sean-galloway/jetson-marker-turret/turret-gimbal/datasheets/INDEX.md

# Gimbal — Datasheets Index

Reference files for confirmed parts. Naming: `BOM#_part_part-number`. Maps to Section A of `Gimbal_BOM.xlsx`.

| BOM # | Part | Part number | File | Status |
|---|---|---|---|---|
| 1 | Closed-loop driver (×2, ships in the motor kit) | STEPPERONLINE **CL57T V4.1** | `01_driver_CL57T-V4.1_manual.pdf` | Confirmed · both units checked V4.1 |
| 2 | Planetary gearbox 5:1 | Ratio 5:1 Nema 23, Ø8 bore | `02_gearbox_5to1_Nema23_phi8mm.jpeg` | Confirmed |
| 3 | Turntable bearing | 8" lazy susan, 265 lb (VXB) | `03_turntable-bearing_8in-lazy-susan-265lb.png` | Bought · **needs measurement** |
| 4 | Tilt bearing | McMaster **5968K71** | `04_tilt-bearing_McMaster_5968K71.png` | Confirmed · need flange dims |
| 5 | Mounting hub (×2) | Ruland **FHT-MCL-14-SS** | `05_mounting-hub_Ruland_FHT-MCL-14-SS.pdf` | Confirmed · pattern known (Ø22, 2× M4) |
| 6 | Shoulder screw | McMaster **90298A716** | `06_shoulder-screw_McMaster_90298A716.png` | Confirmed |
| 10 | Power supply | DROK 48 V / 10 A / 480 W | `10_power-supply_DROK_48V-10A-480W.png` | Confirmed |
| 12 | Dowel pins | McMaster **91595A161** | `12_dowel-pins_McMaster_91595A161.png` | Confirmed |

## Still needed (not yet on file)
- **#1 Motor** (23HS45-4204D-E1000) — no motor datasheet here yet (StepperOnline/Amazon); the driver manual is on file.
- **#4 bearing flange dims** — the file is the catalog table; the exact 2-bolt flange spacing + hole Ø come from the McMaster product drawing (or match-drill plate 05).
- **#3 lazy susan pattern** — needs physical measurement (4 holes: PCD + hole Ø, both faces) once it arrives → makes plates 02/03.
- **Tripod head** — needs a straight-down photo → makes plate 06.

## Not a datasheet
- `IMG_5335.jpeg` (left in uploads) — photo of received screens + calibration checkerboard, not a part spec.
