sean-galloway/jetson-marker-turret/turret-gimbal/datasheets/02_gearbox_5to1_Nema23_phi8mm.jpeg

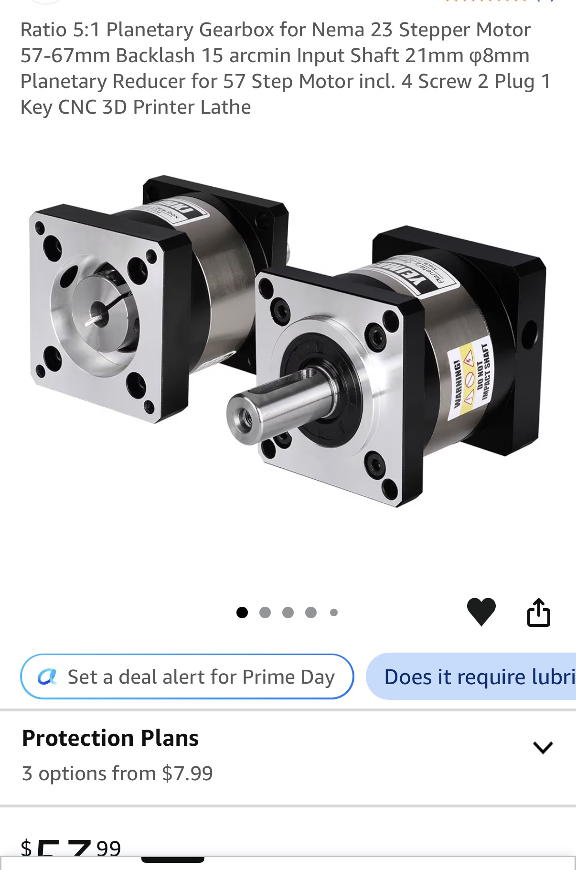
turret-gimbal/datasheets/02_gearbox_5to1_Nema23_phi8mm.jpeg
