sean-galloway/jetson-marker-turret/turret-gimbal/datasheets/03_turntable-bearing_8in-lazy-susan-265lb.png

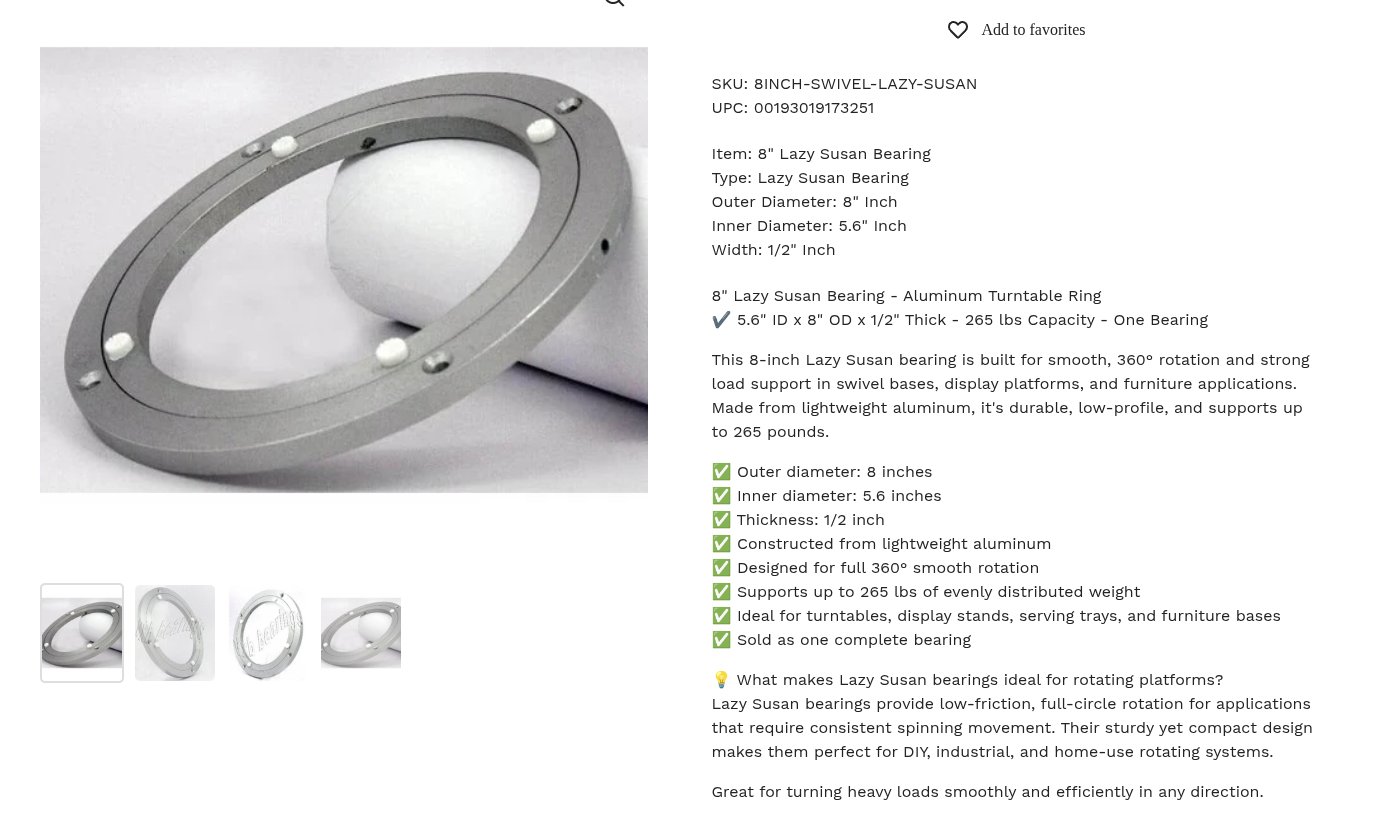
turret-gimbal/datasheets/03_turntable-bearing_8in-lazy-susan-265lb.png
