sean-galloway/jetson-marker-turret/turret-gimbal/datasheets/04_tilt-bearing_McMaster_5968K71.png

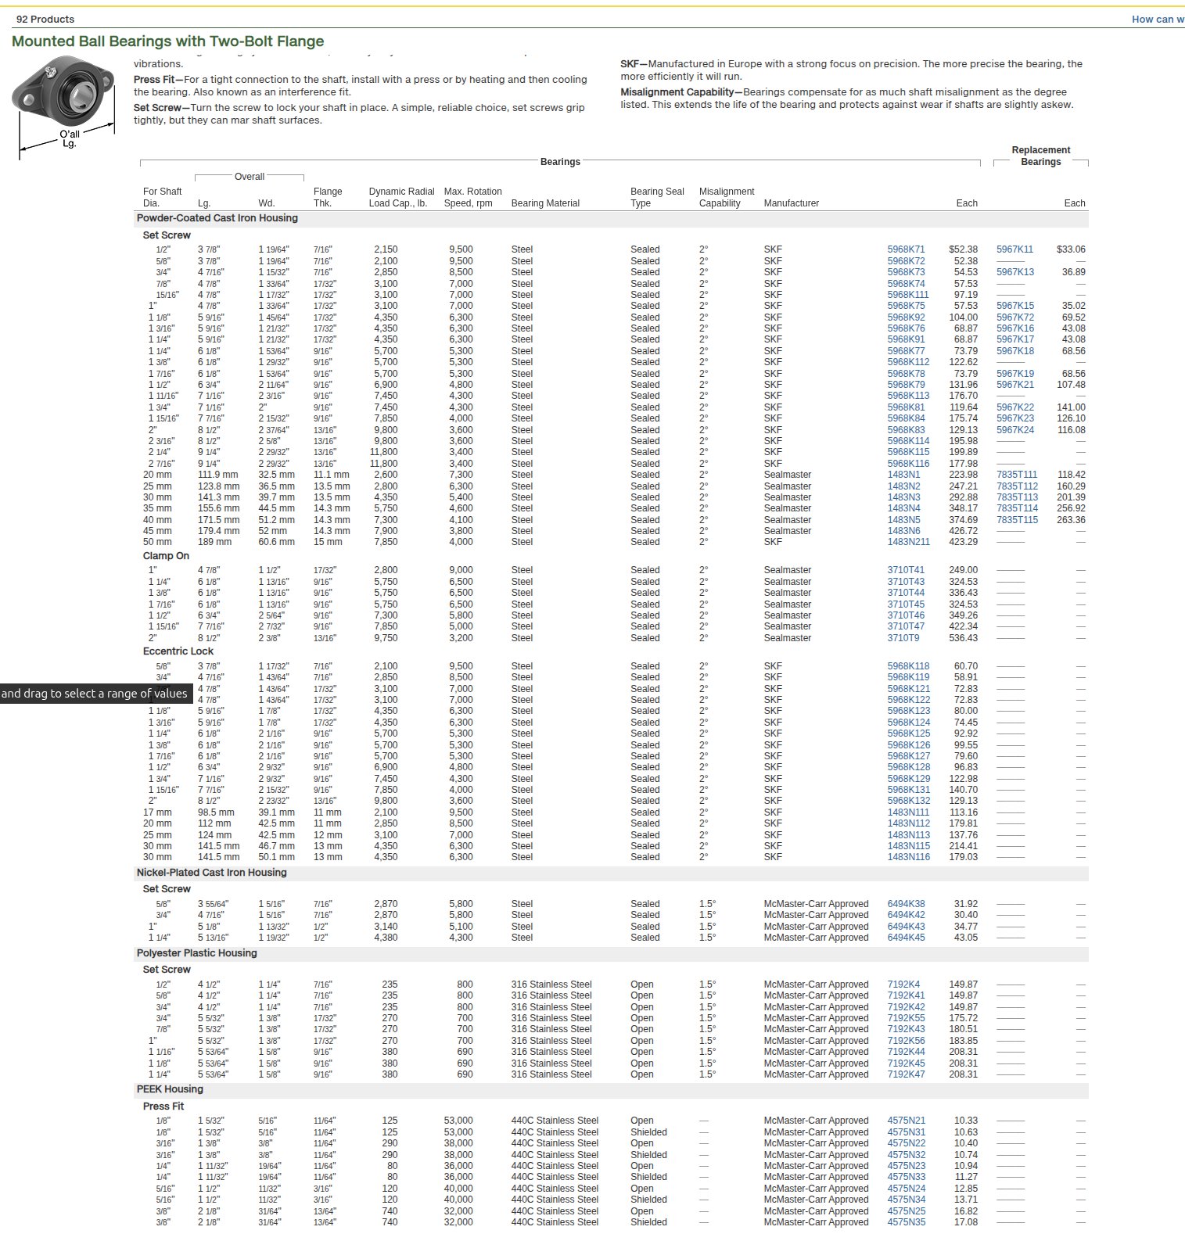
turret-gimbal/datasheets/04_tilt-bearing_McMaster_5968K71.png
