sean-galloway/jetson-marker-turret/turret-gimbal/datasheets/06_shoulder-screw_McMaster_90298A716.png

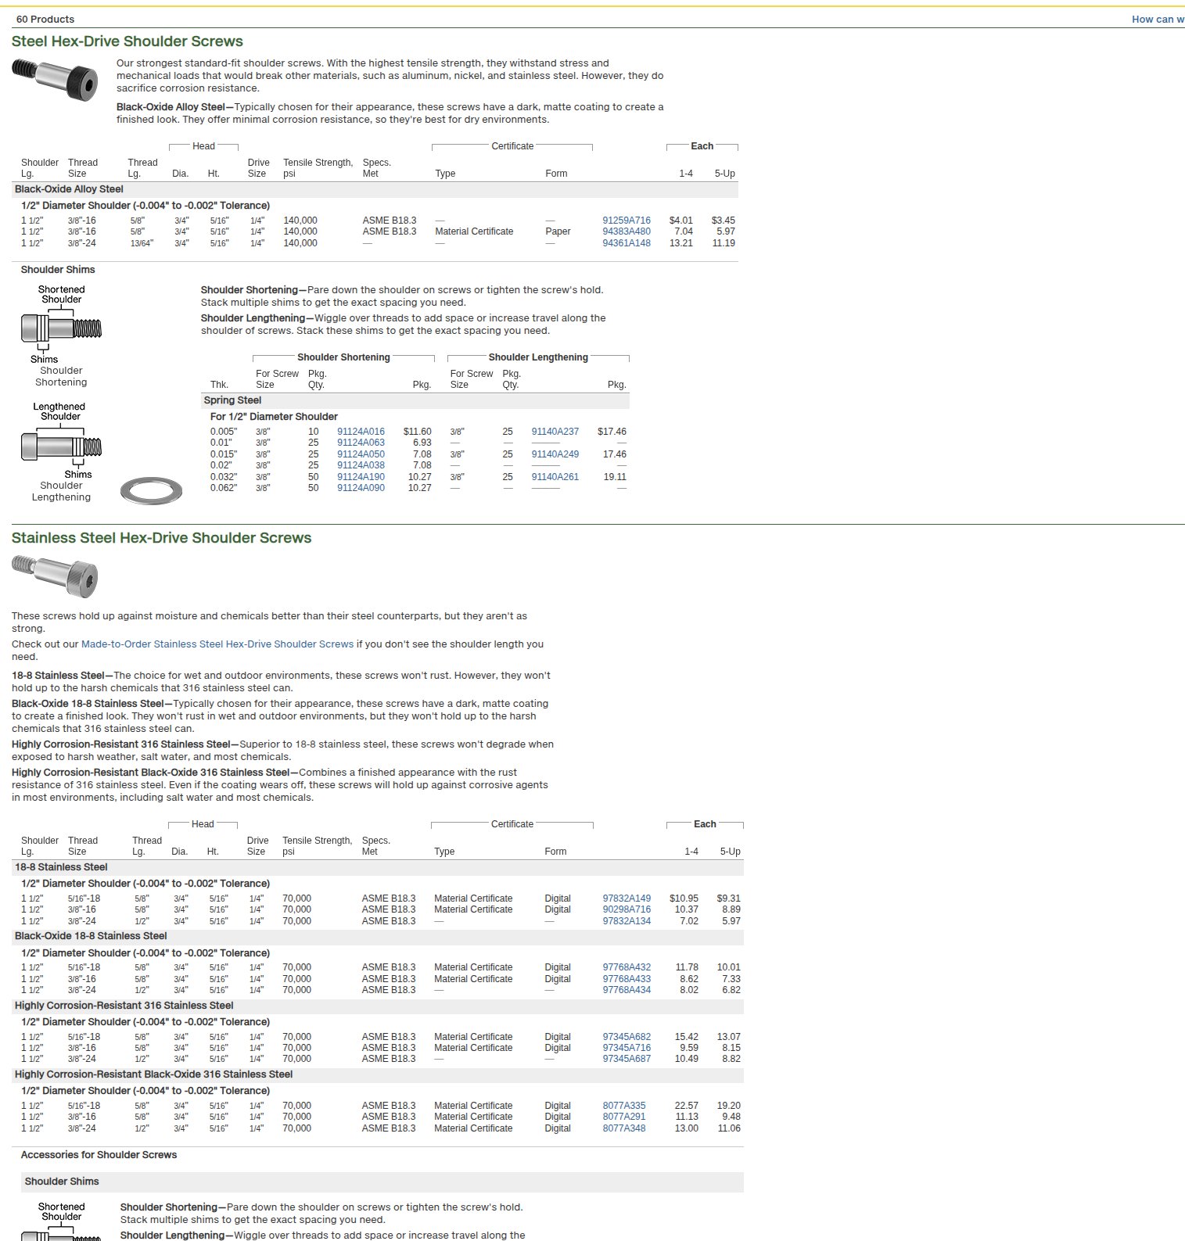
turret-gimbal/datasheets/06_shoulder-screw_McMaster_90298A716.png
