sean-galloway/jetson-marker-turret/turret-gimbal/datasheets/10_power-supply_DROK_48V-10A-480W.png

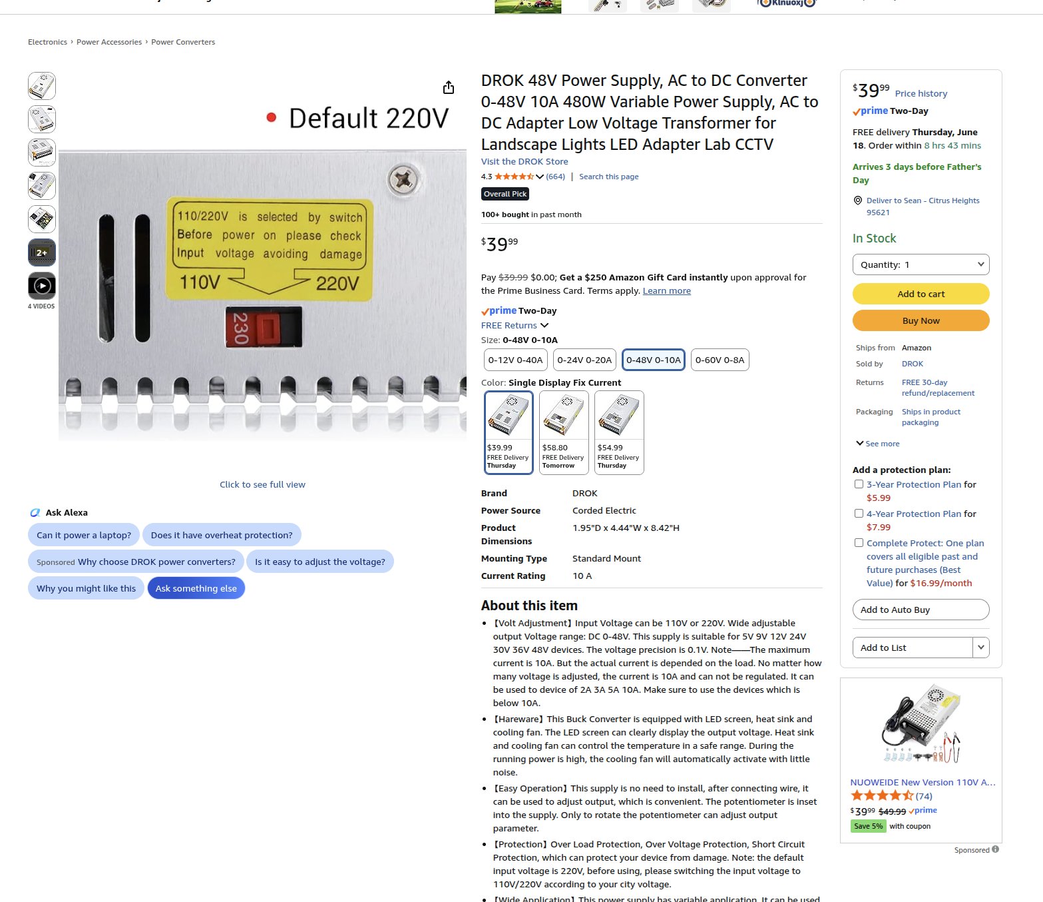
turret-gimbal/datasheets/10_power-supply_DROK_48V-10A-480W.png
