sean-galloway/jetson-marker-turret/turret-gimbal/datasheets/12_dowel-pins_McMaster_91595A161.png

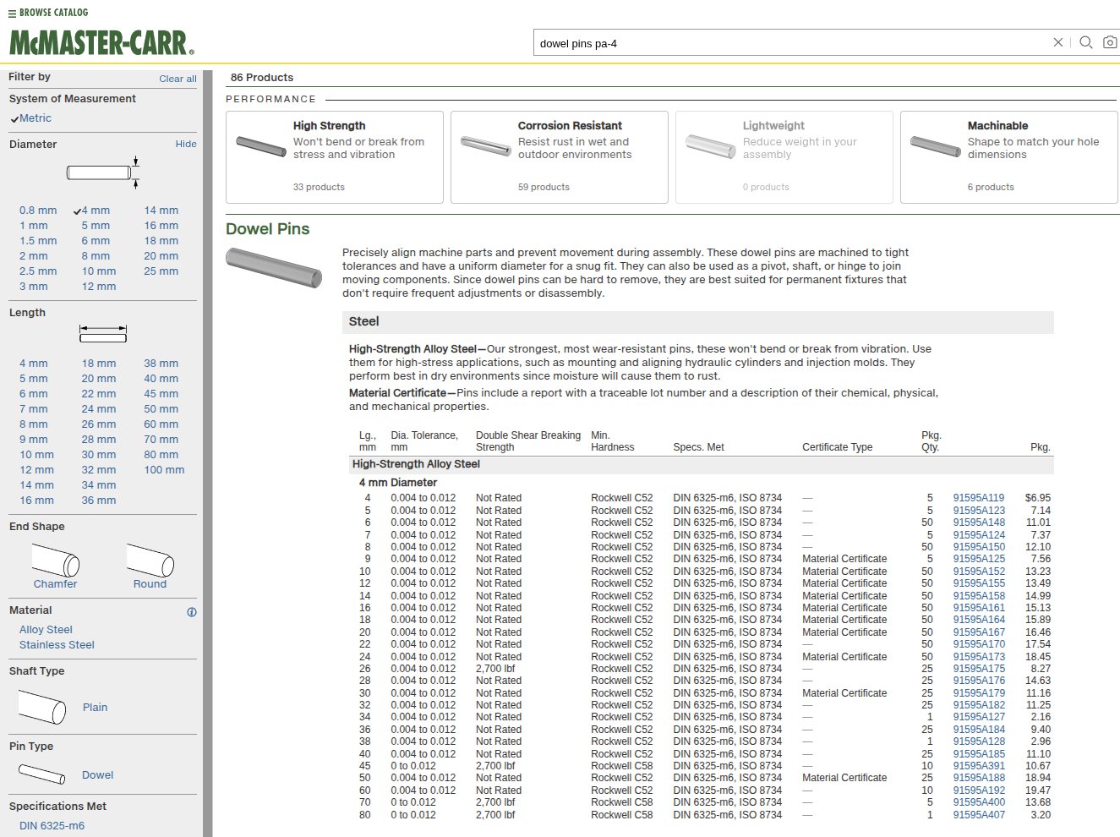
turret-gimbal/datasheets/12_dowel-pins_McMaster_91595A161.png
