sean-galloway/jetson-marker-turret/turret-gimbal/docs/assets/drawings/d1_exploded_full.png

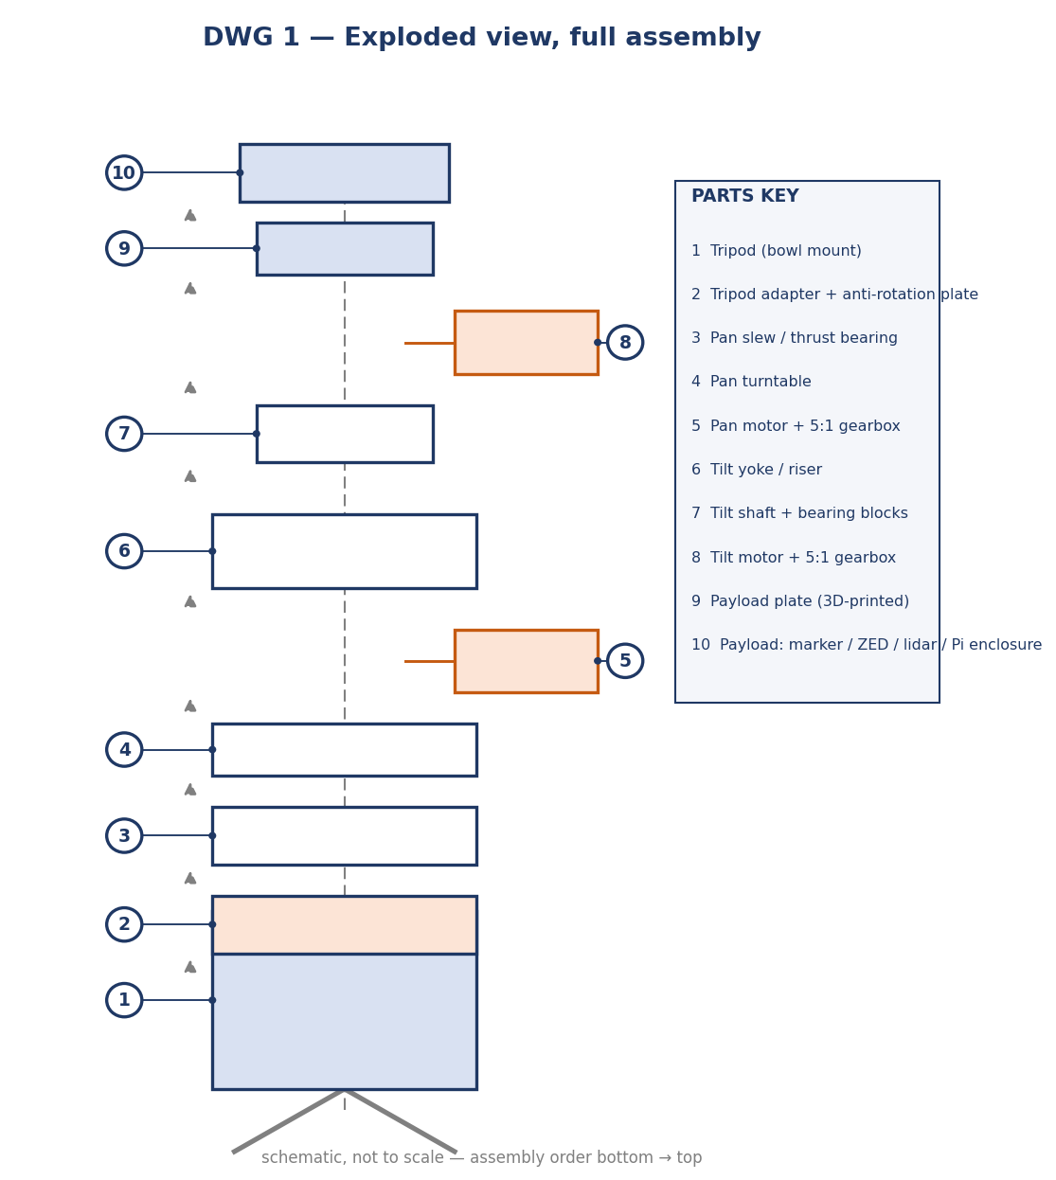
turret-gimbal/docs/assets/drawings/d1_exploded_full.png
