sean-galloway/jetson-marker-turret/turret-gimbal/docs/assets/proimg/pa4_payload_plate.png

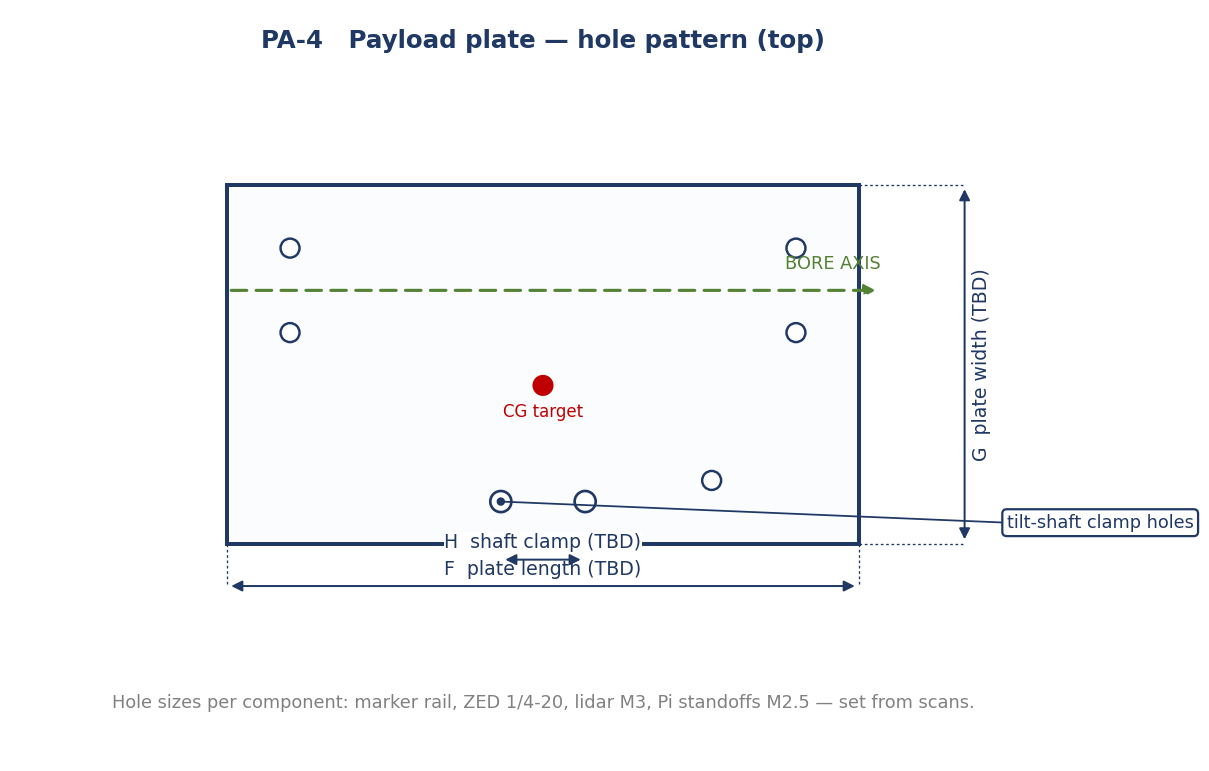
turret-gimbal/docs/assets/proimg/pa4_payload_plate.png
