sean-galloway/jetson-marker-turret/Turret_BOM_checklist.md

# Paintball Turret — Purchase Checklist

> Sections A–D: the turret system (payload on the gun · compute on the tripod · displays · power/wiring). Sections E–G: the bolt-together gimbal — BUY catalog · CUT (DXF, SendCutSend) · HAVE. Owned items are priced $0 so they stay out of the totals.

Two clickable boxes per item — **Ordered** and **Received** (works in GitHub, VS Code, Obsidian). Owned items are pre-ticked on both.

## A.  PAYLOAD — ON THE TURRET

- **#1 Paintball marker** — Bore-sighted reference for the ZED · owned
  
  - [x] Ordered
  
  - [x] Received
  
  - _Owned. Bore aligns to the pan axis; hopper top-rear._

- **#2 Push-pull solenoid (trigger)** — 12 V, 1 A, 20 N, 10 mm stroke · $13.99 · TOMMSILE 0837B-12V (Amazon)
  
  - [x] Ordered
  
  - [x] Received
  
  - _Trigger actuator; 12 V switched. 20 N is end-of-stroke; confirm trigger force after marker scan. Wire to a HAT high-current channel (CH1-4); onboard TVS handles flyback._

- **#3 Arming switch (SPST, LED, safety cover)** — SPST maintained, 20 A @ 12 V DC, illuminated, flip-up cover, 12 mm hole; in the 12 V solenoid+ line · $9.66 · Twidec ASW-07DRGYMZ (3-pack, Amazon) · 3rd pin = LED→GND (RED when armed); real interlock, not the panel's soft ARM
  
  - [x] Ordered
  
  - [x] Received
  
  - _HARDWARE INTERLOCK: open = cannot fire. Safety-critical._

- **#4 Laser sight (boresight aid)** — Mounts on top of the barrel · $15 · generic
  
  - [x] Ordered
  
  - [x] Received
  
  - _Zero to impact point at a set range, like a rifle._

- **#5 ZED 2i stereo camera** — 4 mm, polarizer; USB 3.0 · Stereolabs ZED 2i 4mm
  
  - [x] Ordered
  
  - [ ] Received
  
  - _Owned (~$549). Boresighted below the barrel; routes to the Jetson._

- **#6 ZED USB3 locking cable (3 m)** — USB 3.0 Type-C locking · Stereolabs
  
  - [x] Ordered
  
  - [ ] Received
  
  - _Owned._

- **#7 10-DOF IMU (BNO055 + BMP280)** — I2C Gravity plug (no solder); run IMU mode (no mag) · $25.90 · DFRobot Gravity SEN0253 · [link](https://www.dfrobot.com/product-1793.html)
  
  - [x] Ordered
  
  - [x] Received
  
  - _Leveling + stabilization; rigid to platform. Use IMU (no-mag) mode near steppers. Local I2C to the on-turret Pico (short run; no extender)._

- **#8 Benewake TF03 lidar (100 m)** — Single-point rangefinder; UART/CAN; IP67 · $220 · TF03-100
  
  - [x] Ordered
  
  - [x] Received
  
  - _Boresighted to the muzzle; range along the line of fire._

- **#9 Armed/Safe LED indicator (RED + GREEN)** — 12 mm metal, 12 V, IP67, pre-wired w/ internal resistor; on the turret · $27.18 · FILN 12mm IP67 (1 red + 1 green 2-pk) · RED on armed rail; GREEN via 12 V SPDT relay (XOR) or as power/ready light
  
  - [ ] Ordered
  
  - [ ] Received
  
  - _RED ARMED off the armed rail (hardware-true); GREEN SAFE. On the turret._

## B.  COMPUTE & CONTROL — ON THE TRIPOD

- **#10 NVIDIA Jetson AGX Orin 32 GB** — Vision/targeting module · AGX Orin 32GB
  
  - [x] Ordered
  
  - [x] Received
  
  - _Owned. Perception/targeting._

- **#11 Raspberry Pi 5 (8 GB)** — Supervisor · $80 · SC1112
  
  - [x] Ordered
  
  - [x] Received
  
  - _Setpoints, IMU/lidar, arming, state._

- **#12 Pi 5 Active Cooler** — — · $5 · SC1148
  
  - [x] Ordered
  
  - [x] Received
  
  - _Pi 5 throttles without it._

- **#13 Pi 27 W USB-C PD supply** — 5.1 V / 5 A · $12 · SC1158
  
  - [x] Ordered
  
  - [x] Received
  
  - _Powers the Pi + HAT reliably._

- **#14 microSD 64 GB A2** — — · $10 · SanDisk SDSQXAV-064G
  
  - [x] Ordered
  
  - [x] Received
  
  - _Pi OS / boot._

- **#15 Solenoid driver HAT (8-MOSFET)** — I2C; solid-state · $45 · Sequent Eight-MOSFETS
  
  - [x] Ordered
  
  - [x] Received
  
  - _Trigger drive; the only HAT on the stack now. Solenoid on a high-current channel (CH1-4): 12A@24V, onboard TVS clamps flyback — no external diode (CH5-8 are 240V/flyback-diode). CH5 = 48 V motor-rail enable: in series with the E-stop NC in the #64 coil return (see Drive_and_Cabling.md)._

- **#16 GPIO stacking header, 2×20 tall** — — · $3 · Adafruit 2223
  
  - [x] Ordered
  
  - [x] Received
  
  - _Passes GPIO up past the HAT._

- **#17 Top-of-stack GPIO breakout / proto-HAT** — — · $8 · Adafruit 2310
  
  - [x] Ordered
  
  - [x] Received
  
  - _Expose SPI (IMU), UART (lidar + the Pico link, via the #70 RS-485 transceiver), spare GPIO._

- **#18 Brass standoff / spacer kit (M2.5)** — — · $8 · generic
  
  - [x] Ordered
  
  - [x] Received
  
  - _Mount/space the HAT + Pi._

- **#19 Limit / homing switches** — 3D-printer mechanical endstop (lever microswitch on PCB, 1 m cable + plug, trigger LED, NO); GPIO to Pico · $10.99 · R REIFENG endstop (6-pack; 2 used + 4 spare)
  
  - [x] Ordered
  
  - [ ] Received
  
  - _One per axis → power-up homing → absolute aiming._

- **#20 Pico RP2040** — Motion coprocessor (step/dir) · $5 · Raspberry Pi Pico
  
  - [x] Ordered
  
  - [x] Received
  
  - _Drives both CL57T. ON THE TURRET with the drivers; reads IMU/limits/LED locally._

- **#21 Pico debug OLED (SSD1306)** — 128×64; I2C · $9 · Adafruit 938
  
  - [x] Ordered
  
  - [x] Received
  
  - _Pico debug: current routine/state, step/dir, homing, heartbeat, faults._

- **#70 RS-485 transceiver modules** — 3.3 V TTL↔RS-485, automatic direction control (MAX13487-class), onboard 120 Ω termination · $9.99 · generic 5-pack
  
  - [ ] Ordered
  
  - [ ] Received
  
  - _Pi 5↔Pico link over the umbilical: one at the Pi 5 UART (rack), one at the Pico UART (turret); half-duplex A/B on one twisted pair. Leave the 120 Ω fitted at both ends only. Price est._

- **#71 Raspberry Pi Zero 2 W (maintenance node)** — Wi-Fi 2.4 GHz; USB OTG set to host · owned · SC0510
  
  - [x] Ordered
  
  - [x] Received
  
  - _Owned (hostname turret-zero). OPTIONAL, on the turret beside the Pico: flash the Pico (mpremote) and tail its logs over Wi-Fi. NEVER in the command or heartbeat path._

- **#72 Turret 5 V buck (logic rail)** — 9–60 V in → 5 V, 3 A out · $11.99 · generic
  
  - [ ] Ordered
  
  - [ ] Received
  
  - _Turret logic: Pico + ELRS RX + IMU + OLED + Zero (~1.2 A peak). Feed point (switched vs unswitched 48 V) is open — see Drive_and_Cabling.md. Price est._

- **#73 Step/dir output buffer** — 74LVC07A hex open-drain buffer, 3.3 V in, 5 V-tolerant outputs, 24 mA sink; SOIC-14 + SOIC-14→DIP adapter · $9.79 · TI SN74LVC07AD ×3 (~$0.60 ea) + adapter pack ($7.99)
  
  - [ ] Ordered
  
  - [ ] Received
  
  - _Pico 3.3 V GPIO → CL57T opto inputs (need 3.5–5 V, 7–16 mA). One chip = all 6 channels (PUL/DIR/ENA ×2); 2 spares. Plus 6× 10 kΩ pull-downs + 0.1 µF decoupling (stock). Wiring: Drive_and_Cabling.md. Price est._

## C.  DISPLAYS & CALIBRATION

- **#22 1U rack display — Pi 5 (GeeekPi 6.91")** — 1424×280 touch, 1U rack mount · $89.99 · GeeekPi 6.91" 1U
  
  - [x] Ordered
  
  - [x] Received
  
  - _Pi 5 status/console bar. Bought; price est._

- **#23 1U rack display — Jetson (GeeekPi 6.91")** — 1424×280 touch, 1U rack mount · $89.99 · GeeekPi 6.91" 1U
  
  - [x] Ordered
  
  - [x] Received
  
  - _Jetson perception/status bar. Bought; price est._

- **#24 Checkerboard calibration target** — Rigid flat backing · owned
  
  - [x] Ordered
  
  - [x] Received
  
  - _Owned. Camera + boresight calibration._

- **#25 micro-HDMI → HDMI cable** — — · $7 · generic
  
  - [x] Ordered
  
  - [x] Received
  
  - _Pi 5 micro-HDMI → 6.91" display._

- **#26 DisplayPort → HDMI adapter** — — · $9 · generic
  
  - [x] Ordered
  
  - [x] Received
  
  - _AGX Orin DP → 6.91" display; verify._

## D.  POWER & WIRING

- **#27 12 V solenoid supply (adjustable)** — 3–24 V, 3 A, 72 W; set & lock at 12 V · $17.99 · Wefomey adjustable (Amazon)
  
  - [x] Ordered
  
  - [ ] Received
  
  - _Solenoid rail. Set 12 V on the display + lock the knob; center-positive tip. Motors use 48 V (#41)._

- **#28 Circuit protection — fuses + 48 V DC breaker** — ATC inline holders + fuse kit (12 V/logic) + DIHOOL 15 A DC breaker (48 V) · $26 · SIM&NAT (B0CN6TVHKH) + DIHOOL (B0CFCLPGNY) · fuses https://www.amazon.com/SIM-NAT-Automotive-Standard-Replacement/dp/B0CN6TVHKH · breaker https://www.amazon.com/DIHOOL-Disconnect-Breaker-Circuit-Outdoor/dp/B0CFCLPGNY
  
  - [ ] Ordered
  
  - [ ] Received
  
  - _Fuse the 24–48 V and 12 V rails; tie ALL grounds together._

- **#29 Ethernet cable, Cat6 (short)** — — · $6 · generic
  
  - [x] Ordered
  
  - [x] Received
  
  - _Pi↔Jetson via the rack switch (#55); short rack-internal patch — not on the umbilical._

- **#30 Jumper wires (DuPont M-F, M-M)** — — · $7 · generic
  
  - [ ] Ordered
  
  - [ ] Received
  
  - _Signals: IMU, lidar, Pico, switches._

- **#31 Hookup wire, 18–20 AWG** — — · $10 · generic
  
  - [ ] Ordered
  
  - [ ] Received
  
  - _Motor, solenoid, power runs._

- **#32 Wire ferrules / crimp terminals** — — · $9 · generic
  
  - [ ] Ordered
  
  - [ ] Received
  
  - _Driver/terminal terminations._

## E.  BUY — CATALOG PARTS

- **#33 Motor + driver kit** — NEMA 23 closed-loop 3.0 N·m + CL57T V4.1 · $171.98 · 23HS45-4204D-E1000 / Amazon B0C6943QBM
  
  - [x] Ordered
  
  - [x] Received
  
  - _STEPPERONLINE Closed Loop Stepper Motor 1 Axis CNC KIT 2.0 Nm/283.28oz.in Nema 23 Motor & 0-8.0A 24-48VDC Closed Loop Stepper Driver CL57T V4.1_

- **#34 Planetary gearbox 5:1** — NEMA 23, Ø8 bore, 15 arcmin; out Ø14 / Ø40 reg / 4×Ø5.2@47.14 · $115.98 · Ratio 5:1 Nema 23 … φ8mm
  
  - [x] Ordered
  
  - [x] Received
  
  - _Ratio 5:1 Planetary Gearbox for Nema 23 Stepper Motor 57-67mm Backlash 15 arcmin Input Shaft 21mm φ8mm Planetary Reducer for 57 Step Motor_

- **#35 Turntable bearing (lazy susan)** — Heavy-duty steel/alu, OPEN center, 6–8 in · $20 · Search "turntable bearing" / "lazy susan bearing" · McMaster: Ball Bearing Turntables · `193019173251` · [link](https://vxb.com/checkouts/cn/hWNDQZKNqS7FLBgAANhKclaa/en-us/thank-you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)
  
  - [x] Ordered
  
  - [x] Received
  
  - _8INCH-SWIVEL-LAZY-SUSAN — **measured part: see [Bearing_Dimensions](turret-gimbal/docs/Bearing_Dimensions.md)**_

- **#36 Mounted ball bearing (tilt)** — Flange-mount or pillow block; bore = pin Ø (e.g. 1/2") · $15 · McMaster: "mounted ball bearing" · `5968K71` · [link](https://www.mcmaster.com/products/mounted-ball-bearings/mounted-ball-bearings-with-two-bolt-flange~~/mounted-bearing-type~two-bolt-flange-mount/)
  
  - [x] Ordered
  
  - [x] Received
  
  - _Match pattern to plate 05_

- **#37 Mounting hub** — Clamps gearbox Ø14 shaft → bolts to plate; bore 14 mm · $36 · McMaster: "mounting hub" · Ruland · `FHT-MCL-14-SS` · [link](https://www.ruland.com/fht-mcl-14-ss.html#)
  
  - [x] Ordered
  
  - [x] Received
  
  - _Or rigid shaft coupling; no keyway_

- **#38 Shoulder screw (tilt pin)** — Shoulder Ø = #36 bearing bore (e.g. 1/2") · $8 · McMaster: "shoulder screw" · `90298A716` · [link](https://www.mcmaster.com/products/shoulder-screws/shoulder-diameter~1-2/shoulder-length~1-1-2/)
  
  - [x] Ordered
  
  - [x] Received
  
  - _Far end of tilt axis; pairs with #36_

- **#39 L-brackets / gussets** — Join yoke side-plates to turntable + stiffen · $32 · 8020 / McMaster · [link](https://www.mcmaster.com/products/l-brackets/brackets-1~/)
  
  - [ ] Ordered
  
  - [ ] Received
  
  - _Bolt-together corners_

- **#40 Standoffs** — M5, raise base plate over tripod adapter · $12 · McMaster
  
  - [ ] Ordered
  
  - [ ] Received
  
  - _Length = motor/gbx clearance_

- **#41 Power supply 24–48 V** — 48 V, 5–10 A · $40 · select
  
  - [x] Ordered
  
  - [x] Received
  
  - _DROK 48V Power Supply, AC to DC Converter 0-48V 10A 480W Variable Power Supply, AC to DC Adapter Low Voltage Transformer_

- **#42 Fasteners + NUTS** — M5/M6/M3 SHCS, nuts, washers (clearance-hole build) · $35 · McMaster / assorted · `92275A110` · [link](https://www.mcmaster.com/products/socket-head-cap-screw-assortments/system-of-measurement~metric/)
  
  - [ ] Ordered
  
  - [ ] Received
  
  - _Nuts replace tapping_

- **#43 Dowel pins** — Ø4 mm (PA-4 interface) · $8 · McMaster · `91595A161` · [link](https://www.mcmaster.com/products/dowel-pins/dowel-pins-1~~/system-of-measurement~metric/diameter~4-0000-mm/diameter~4-000-mm/diameter~4-mm/)
  
  - [ ] Ordered
  
  - [ ] Received
  
  - _Reamed-fit_

- **#44 Consumables** — Threadlocker (medium) + anti-seize · $12 · — · `7458A65` · [link](https://www.mcmaster.com/products/loctite-kits/manufacturer-model-number~243/)
  
  - [ ] Ordered
  
  - [ ] Received
  
  - _Loctite 243 kits_

## F.  CUT — DXF FLAT PLATES (6061-T6; files supplied; one SendCutSend order)

- **#45 Pan base plate** — 6 mm; file 02_base_plate_pan.dxf · $28 · DXF
  
  - [ ] Ordered
  
  - [ ] Received
  
  - _Gearbox + slew bearing + standoffs_

- **#46 Turntable plate** — 6 mm; file 03_turntable_plate.dxf · $28 · DXF
  
  - [ ] Ordered
  
  - [ ] Received
  
  - _Slew bearing + yoke feet_

- **#47 Yoke side — gearbox** — 6 mm; file 04_yoke_side_gearbox.dxf · $25 · DXF
  
  - [ ] Ordered
  
  - [ ] Received
  
  - _Gearbox flange_

- **#48 Yoke side — trunnion** — 6 mm; file 05_yoke_side_trunnion.dxf · $25 · DXF
  
  - [ ] Ordered
  
  - [ ] Received
  
  - _Pillow-block bearing_

- **#49 Interface plate (PA-4)** — 6 mm; file 01_interface_plate_PA4.dxf · $28 · DXF
  
  - [ ] Ordered
  
  - [ ] Received
  
  - _Payload mount (Ø70 BC/dowels/Ø14)_

- **#50 Tripod adapter** — 6 mm; file 06_tripod_adapter.dxf · $25 · DXF
  
  - [ ] Ordered
  
  - [ ] Received
  
  - _Mates your tripod head_

## G.  HAVE

- **#51 Tripod** — 35 lb (you own) · —
  
  - [x] Ordered
  
  - [x] Received
  
  - _Watch flex under fast slews; confirm bowl_

## H.  GROUND STATION — 10" RACK

- **#52 10" rack — DeskPi RackMate T2** — 12U, 10" wide, 10.23" (~260 mm) deep · $100 · GeeekPi / DeskPi RackMate T2
  
  - [x] Ordered
  
  - [ ] Received
  
  - _Houses compute, PSUs, drivers, displays. Bought; price est._

- **#53 10" rackmount PDU** — 8 outlets, surge, 15 A switch, 1U · $69.99 · ElecVoztile 10" PDU
  
  - [x] Ordered
  
  - [ ] Received
  
  - _All AC onboard; one cord to wall. Bought; price est._

- **#54 E-stop (22 mm, 2NC 2NO)** — Gebildet latching, 3 A, connection plug · $9.99 · Gebildet (Amazon)
  
  - [x] Ordered
  
  - [ ] Received
  
  - _Breaks 12 V solenoid directly + pilots the 48 V cutoff solenoid (#64). Spare NO → Pi "E-stop pressed" input. Safety-critical._

- **#55 Gigabit Ethernet switch** — TP-Link TL-SG108E, 8-port, managed · $19.99 · TP-Link TL-SG108E
  
  - [x] Ordered
  
  - [ ] Received
  
  - _Pi + Jetson + uplink (SSH/updates). Bought; price est._

- **#56 DIN rail + terminal/ground bus** — Dinkle DK2.5N kit: 20 blocks + 35 mm rail + ground blocks + jumpers + end brackets · $23 · ICI Dinkle DK2.5N (B07NVV28D9) · https://www.amazon.com/International-Connector-Dinkle-DK2-5N-Connectors/dp/B07NVV28D9
  
  - [ ] Ordered
  
  - [ ] Received
  
  - _Distribute/fuse 48 V & 12 V (with #28); tie all grounds._

- **#57 Umbilical connectors + bulkhead** — GX20 12-pin (power+signal) + USB3 panel coupler (ZED) · $30 · GX20-12 (B0D4VBV42Q) + PENGLIN USB3 IP67 (B09VNS64HM) · GX20 https://www.amazon.com/Connector-Circular-Aviation-Adapter-Connection/dp/B0D4VBV42Q · USB3 https://www.amazon.com/PENGLIN-Waterproof-Connector-Bulkhead-Extension/dp/B09VNS64HM
  
  - [ ] Ordered
  
  - [ ] Received
  
  - _Rack↔turret disconnect: 48 V motor power, switched solenoid pair (2 cond, from the rack HAT), Pi↔Pico RS-485 pair (#70), ZED USB, ground (no motor phases/step-dir). Price est._

- **#58 Umbilical cable sleeve / wrap** — Braided / spiral wrap · $15 · generic
  
  - [x] Ordered
  
  - [x] Received
  
  - _The single sleeved bundle, tripod↔rack._

- **#59 Blank + vent rack panels** — 10" panels · $0 · MAKE (3D print)
  
  - [ ] Ordered
  
  - [ ] Received
  
  - _Fill gaps; airflow._

- **#60 Cable manager (0.5U D-ring bar)** — Tecmojo 2-pack, metal, 3 D-rings, 10" · $9.90 · Tecmojo 0.5U (2-pack)
  
  - [x] Ordered
  
  - [ ] Received
  
  - _2 bars/pack; rack cable management._

- **#61 Jetson/Pi 5/Pico rack shelf** — 3D print; standoffs + vents · MAKE (3D print)
  
  - [ ] Ordered
  
  - [ ] Received
  
  - _To be designed._

- **#62 12-port Cat6 patch panel** — 1U; keystone + cable bar · $24.99 · GeeekPi 12-port
  
  - [x] Ordered
  
  - [ ] Received
  
  - _Network breakout; part of the umbilical interface. Bought; price est._

- **#63 Switch rack mount (PETG)** — 1U mount for TL-SG108 · $34.99 · generic PETG
  
  - [x] Ordered
  
  - [ ] Received
  
  - _Racks the TL-SG108E. Bought; price est._

- **#64 48 V cutoff solenoid (E-stop)** — 48 V, 4-term, 200 A work / 500 A inrush, copper · $34.99 · 10L0L #586 (73231G01 repl., Amazon) · backups: universal (B0076Q9HNM), EZGO 73231G01 (B0076Q9FFM)
  
  - [ ] Ordered
  
  - [ ] Received
  
  - _E-stop NC drops the coil → opens the 48 V motor rail (fail-safe). 3 A E-stop can't switch 48 V directly. Coil return runs E-stop NC → HAT CH5 (#15) → GND, so the Pi 5 can also cycle the rail (clears latched CL57T faults); E-stop still breaks it independently. Measure coil R: 48 V/R must be within CH5's rating. Price est._

## I.  CONTROL / TEST (operator console)

- **#65 RadioMaster TX16S Mk II (ELRS)** — EdgeTX, 16CH, Hall gimbals, 4.3" touch · $239.99 · RadioMaster TX16S MkII ELRS
  
  - [x] Ordered
  
  - [x] Received
  
  - _Manual jog + Lua telemetry console. MOTION ONLY (not firing)._

- **#66 ELRS receiver (CRSF)** — RadioMaster RP3, 2.4 GHz, antenna diversity · $24.99 · RadioMaster RP3
  
  - [x] Ordered
  
  - [x] Received
  
  - _CRSF → Pico UART (3.3 V logic); 5 V power. Set failsafe → Pico stop-hold._

- **#67 18650 cells (×2)** — Li-ion, for the TX16S (USB-C charge) · $12 · generic 18650 ×2
  
  - [x] Ordered
  
  - [x] Received
  
  - _Radio battery (not included). Price est._

## J.  PRINTED PARTS — TURRET (MAKE)

- **#68 Turret electronics base** — 3D print; holds Pico + 2× CL57T + IMU, vented · MAKE (3D print)
  
  - [ ] Ordered
  
  - [ ] Received
  
  - _Bolts to the pan base plate; IMU senses base level. cad/scad/turret_electronics_base.scad_

- **#69 Barrel shroud (boresight mount)** — 3D print; holds ZED (below barrel) + lidar (to muzzle) · MAKE (3D print)
  
  - [ ] Ordered
  
  - [ ] Received
  
  - _Rigid boresight mount. **Gated on the marker scan** (barrel OD/length/bore)._

## Totals

- **Grand total (to-buy):** $2,126.24
- **Electronics & payload (A–D):** $811.46
- **Gimbal — catalog (E):** $505.96
- **Gimbal — DXF plates (F):** $159
- **Ground station — rack (H):** $372.84
- **Control / test (I):** $276.98
