sean-galloway/jetson-marker-turret/turret-gimbal/bom/Gimbal_BOM.xlsx

Gimbal — Bolt-Together BOM
No machining. BUY = catalog part · CUT(DXF) = flat plate from SendCutSend · HAVE = you own it. Plates use clearance holes + nuts (no tapping) and no precision pilots (camera corrects centering).
# | Item | Spec | P/N or Source | Qty | Unit $ | Line $ | Process | Notes
A. BUY — CATALOG PARTS
1 | Motor + driver kit | NEMA 23 closed-loop 3.0 N·m + CL57T V4.1 | 23HS45-4204D-E1000 / Amazon B0C6943QBM | 2 | $85.99 | $171.98 | Buy | Confirmed
2 | Planetary gearbox 5:1 | NEMA 23, Ø8 bore, 15 arcmin; out Ø14 / Ø40 reg / 4×Ø5.2@47.14 | Ratio 5:1 Nema 23 … φ8mm | 2 | $57.99 | $115.98 | Buy | Confirmed
3 | Turntable bearing (lazy susan) | Heavy-duty steel/alu, OPEN center, 6–8 in | Search "turntable bearing" / "lazy susan bearing" · McMaster: Ball Bearing Turntables | 1 | $20.00 | $20.00 | Buy (est.) | Open center passes pan shaft; match bolt circle to plates 02/03
4 | Mounted ball bearing (tilt) | McMaster 5968K71 · 1/2in bore, 2-bolt flange, set-screw, sealed (SKF) | McMaster 5968K71 | 1 | $52.38 | $52.38 | Buy | CONFIRMED. Pairs with 1/2in shoulder screw (#6); match flange pattern to plate 05
5 | Mounting hub | Ruland FHT-MCL-14-SS · 14mm face-mount collar, threaded face holes | Ruland FHT-MCL-14-SS | 2 | $30.00 | $60.00 | Buy | CONFIRMED. Clamps each gearbox Ø14 output; face-bolts pan→plate 03, tilt→plate 01; 2-hole Ø22 pattern
6 | Shoulder screw (tilt pin) | Shoulder Ø = #4 bearing bore (e.g. 1/2") | McMaster: "shoulder screw" | 1 | $8.00 | $8.00 | Buy (est.) | Far end of tilt axis; pairs with #4
7 | L-brackets / gussets | Join yoke side-plates to turntable + stiffen | 8020 / McMaster | 8 | $4.00 | $32.00 | Buy (est.) | Bolt-together corners
8 | Standoffs | M5, raise base plate over tripod adapter | McMaster | 4 | $3.00 | $12.00 | Buy (est.) | Length = motor/gbx clearance
9 | Pico RP2040 | Motion coprocessor (step/dir) | Raspberry Pi Pico | 1 | $5.00 | $5.00 | Buy | Drives both CL57T
10 | Power supply 24–48 V | 48 V, 5–10 A | select | 1 | $40.00 | $40.00 | Buy (est.) | Sizes 2 motors
11 | Fasteners + NUTS | M5/M6/M3 SHCS, nuts, washers (clearance-hole build) | McMaster / assorted | 1 | $35.00 | $35.00 | Buy (est.) | Nuts replace tapping
12 | Dowel pins | Ø4 mm (PA-4 interface) | McMaster | 1 | $8.00 | $8.00 | Buy (est.) | Reamed-fit
13 | Consumables | Threadlocker (medium) + anti-seize | — | 1 | $12.00 | $12.00 | Buy (est.) | —
B. CUT — DXF FLAT PLATES (6061-T6; files supplied; one SendCutSend order)
14 | Pan base plate | 6 mm; file 02_base_plate_pan.dxf | DXF | 1 | $28.00 | $28.00 | Cut (DXF) | Gearbox + slew bearing + standoffs
15 | Turntable plate | 6 mm; file 03_turntable_plate.dxf | DXF | 1 | $28.00 | $28.00 | Cut (DXF) | Slew bearing + yoke feet
16 | Yoke side — gearbox | 6 mm; file 04_yoke_side_gearbox.dxf | DXF | 1 | $25.00 | $25.00 | Cut (DXF) | Gearbox flange
17 | Yoke side — trunnion | 6 mm; file 05_yoke_side_trunnion.dxf | DXF | 1 | $25.00 | $25.00 | Cut (DXF) | Pillow-block bearing
18 | Interface plate (PA-4) | 6 mm; file 01_interface_plate_PA4.dxf | DXF | 1 | $28.00 | $28.00 | Cut (DXF) | Payload mount (Ø70 BC/dowels/Ø14)
19 | Tripod adapter | 6 mm; file 06_tripod_adapter.dxf | DXF | 1 | $25.00 | $25.00 | Cut (DXF) | Mates your tripod head
C. HAVE
20 | Tripod | 35 lb (you own) | — | 1 | $0.00 | $0.00 | Have | Watch flex under fast slews; confirm bowl
 |  |  |  |  | Total (priced): | $731.34
 |  |  |  |  | Buy (A): | $572.34
 |  |  |  |  | DXF plates (B): | $159.00
