sean-galloway/jetson-marker-turret/turret-gimbal/bom/RPi_Turret_Parts_List.xlsx

Sheet: Parts List
Item | Qty | Unit Price (approx, USD) | Ext. Price | Interface | Purpose / Notes
COMPUTE
Raspberry Pi 5 (8GB) | 1 | $80 | $80 | — | Main controller: runs inner control loop, drives both HATs, reads IMU + lidar. 4GB works; 8GB for headroom.
Raspberry Pi 5 Active Cooler | 1 | $5 | $5 | — | Pi5 throttles without active cooling. Cheap and essential.
Official 27W USB-C PD supply (5.1V/5A) | 1 | $12 | $12 | USB-C | Pi5 needs the 5A supply to power stacked HATs/peripherals reliably.
microSD card 64GB A2 | 1 | $10 | $10 | — | OS/boot. A USB SSD is an alternative; NVMe HAT conflicts with stacking the driver HATs.
GIMBAL MOTOR DRIVE
Motor driver HAT (Adafruit DC/Stepper, TB6612) | 1 | $23 | $23 | I2C | 4x H-bridge w/ built-in flyback; drives pan+tilt (2 channels). VERIFY motor stall current; if >1.2A/ch, step up to a Cytron/Pololu driver.
Gimbal motor cables (matching plug, bare-wire end) | 2 | $8 | $16 | — | HAT output -> Vidpro motors. One per motor. You may already have these; non-destructive (controller stays unplugged).
TRIGGER / SOLENOID DRIVE
Solenoid driver HAT (Sequent 8-MOSFET, stackable) | 1 | $45 | $45 | I2C | Solid-state, fast, rated for solenoids; stacks with the motor HAT. Set distinct I2C address via DIP switch.
Push-pull solenoid (Makermotor PN00121, 12V, 10mm) | 1 | $20 | $20 | — | Trigger actuator (the fast option). Omit if you go with a servo instead. Match stroke to trigger travel.
Arming switch or relay (in 12V solenoid line) | 1 | $8 | $8 | — | HARDWARE interlock: breaks solenoid power so it physically cannot fire unless armed. Not a software flag.
IMU
BNO085 9-DoF IMU breakout (Adafruit) | 1 | $20 | $20 | I2C | Onboard fusion + bias tracking. Use 'game rotation vector' (accel+gyro only, NO magnetometer) — motors/solenoid wreck the mag.
STEMMA QT / Qwiic cable | 1 | $1 | $1 | I2C | IMU -> Pi I2C bus (shared with HATs; distinct address). Mount IMU near rotation center to minimize lever-arm accel.
LIDAR
Benewake TF03 single-point lidar (100m) | 1 | $220 | $220 | UART/I2C | Bore-sighted rangefinder; sunlight-compensated, IP67, up to 1kHz. Co-align with the muzzle. Data may instead route to the Jetson.
USB-to-TTL serial adapter (CP2102/FTDI) | 1 | $8 | $8 | USB | Clean way to read TF03 over UART without fighting the Pi's GPIO UART. (Skip if using I2C mode.)
POWER (12V SIDE)
12V DC power supply (>=5A) | 1 | $16 | $16 | — | Feeds motor HAT + solenoid HAT load side. Size for solenoid inrush + 2 motors. Can reuse the Vidpro 12V adapter if rated enough.
Inline fuse holder + fuses | 1 | $6 | $6 | — | Protect the 12V line against motor stall / solenoid fault. TIE ALL GROUNDS together (Pi, 12V supply, both HATs).
WIRING / MECHANICAL
GPIO stacking headers, 2x20 (tall) | 2 | $3 | $6 | — | Stack the two HATs and keep GPIO/I2C accessible.
Brass standoff / spacer kit (M2.5) | 1 | $8 | $8 | — | Mount and space the stacked HATs and the Pi.
Jumper wire assortment (DuPont M-F, M-M) | 1 | $7 | $7 | — | Signal connections (IMU, lidar, arming switch).
Hookup wire, 18-20 AWG | 1 | $10 | $10 | — | Motor and solenoid power runs.
Wire ferrules / crimp terminals | 1 | $9 | $9 | — | Clean terminations into the HAT screw terminals.
ESTIMATED TOTAL |  |  | $530

Sheet: Integration Notes
Integration & wiring notes
• Power: one 5V/5A USB-C supply to the Pi; a separate 12V supply for the motor HAT and solenoid HAT load side. The HATs only SWITCH the 12V — never power motors/solenoid from the Pi rails.
• Common ground is mandatory: tie Pi GND, 12V supply GND, and both HAT grounds together, or signals float and behavior gets erratic.
• Stacking: both driver HATs are I2C and stackable. Use tall 2x20 stacking headers and set distinct I2C addresses (DIP/jumpers) so they don't collide.
• I2C bus is shared: motor HAT + solenoid HAT + BNO085 IMU all sit on the same SDA/SCL with different addresses. Tap I2C from the top of the stack or a Qwiic port for the IMU.
• Motor current: confirm the Vidpro motors' running and stall current before trusting the TB6612 (1.2A/ch, 3A peak). If stall exceeds that, move to a higher-current driver.
• Magnetometer OFF: with DC motors and a solenoid inches away, magnetic heading is unreliable. Run the BNO085 in accel+gyro fusion (game rotation vector) and let the camera be the absolute heading reference.
• Arming interlock: put the switch/relay in series with the 12V solenoid line. Open = the trigger physically cannot fire. This is the hardware safety on the firing path.
• Lidar routing: the TF03 range can read on the Pi (UART via the USB-TTL adapter, or I2C), but if aim/ballistics math lives on the Jetson, route it there instead. Bore-sight it to the muzzle.
• Fuse the 12V line near the supply to protect against a stalled motor or a solenoid fault.
• Prices are ballpark (USD) for budgeting, not quotes; the lidar is the dominant line item.
