sean-galloway/jetson-marker-turret/turret-gimbal/bom/Turret_Full_Parts_List.xlsx

Sheet: Parts List
Item | Part No. / SKU | Protocol / Connection | Qty | Unit $ (approx) | Have? | To-Buy Ext. | Purpose / Notes
COMPUTE
Raspberry Pi 5 (8GB) | SC1112 | - | 1 | $80 |  | $80 | Supervisor: setpoints, IMU/lidar, arming, state.
Pi 5 Active Cooler | SC1148 | - | 1 | $5 |  | $5 | Pi5 throttles without it.
Official 27W USB-C PD supply (5.1V/5A) | SC1158 (US, blk) | USB-C | 1 | $12 |  | $12 | Powers the Pi + HAT reliably.
microSD 64GB A2 (Pi) | SanDisk SDSQXAV-064G | - | 1 | $10 |  | $10 | Pi OS/boot.
NVIDIA Jetson AGX Orin 32GB (module) | AGX Orin 32GB | - | 1 |  | Y | $0 | Owned. Vision/targeting on the tripod.
PERCEPTION (Jetson side)
ZED 2i stereo camera (4mm, polarizer) | Stereolabs ZED 2i 4mm | USB 3.0 | 1 | $549 | Y | $0 | Owned. The vision system. To the Jetson, not the Pi.
ZED USB3 Type-C locking cable (3m) | Stereolabs ZED USB3 3m | USB 3.0 | 1 | $30 | Y | $0 | Owned.
MOTION / PAN-TILT (NEW - replaces Vidpro head + motor HAT)
NEMA 23 closed-loop stepper (encoder, ~3 Nm) | NEMA23 CL ~3Nm | via driver | 2 | $45 |  | $90 | Pan + tilt. Encoder closes the loop - no lost steps under recoil.
Closed-loop stepper driver (CL57-class, 24-48V) | CL57-class | step/dir/enable | 2 | $35 |  | $70 | One per axis; reads the motor encoder.
Planetary gearbox, NEMA 23, ~5:1 low-backlash | planetary 5:1 | - | 2 | $55 |  | $110 | ~15 Nm at axis, low backlash. Worm option on tilt for self-locking holding.
Pan slewing / thrust bearing | slew/thrust brg | - | 1 | $25 |  | $25 | Carries payload + moment loads OFF the motor shaft.
Tilt shaft + bearing blocks (pair) | pillow blocks | - | 1 | $20 |  | $20 | Horizontal tilt-axis support.
Pan-tilt structural hardware (frame/yoke or rotary table) | ServoCity Actobotics (rep.) | - | 1 | $80 |  | $80 | Metal in the load path. Pre-made kit cuts fab. Printed platform bolts to the tilt axis.
Motion coprocessor - Raspberry Pi Pico (RP2040) | Pico SC0915 | UART/SPI to Pi | 1 | $5 |  | $5 | Real-time step/dir + motion profiles + homing. Don't bit-bang steps from Linux.
Limit / homing switches | microswitch | GPIO (Pico) | 2 | $3 |  | $6 | One per axis -> power-up homing -> absolute aiming.
TRIGGER (Pi side)
Solenoid driver HAT (Sequent 8-MOSFET) | Sequent Eight-MOSFETS | I2C | 1 | $45 |  | $45 | Solid-state, fast. The only HAT on the stack now.
Push-pull solenoid (12V, ~10mm stroke) | Makermotor PN00121 | 12V switched | 1 | $20 |  | $20 | Trigger actuator.
Arming switch / relay (in 12V solenoid line) | SPST toggle / 12V relay (gen.) | GPIO + 12V | 1 | $8 |  | $8 | Hardware interlock: open = cannot fire.
Paintball marker | owned | mechanical | 1 |  | Y | $0 | Owned. Bore-sighted to the camera.
SENSORS (Pi side)
BNO085 9-DoF IMU breakout | Adafruit 4754 | SPI | 1 | $20 |  | $20 | Accel+gyro (no mag). Leveling + stabilization.
Benewake TF03 single-point lidar (100m) | TF03-100-UART/CAN | UART | 1 | $220 |  | $220 | Bore-sighted rangefinder.
OLED debug screen (SSD1306, 128x64) | Adafruit 938 (or gen.) | I2C | 1 | $9 |  | $9 | On-gun ARMED/SAFE + range.
DISPLAYS & CALIBRATION
10.1in capacitive touchscreen (Pi console) | 10.1in Pi touch | HDMI + USB | 1 |  | Y | $0 | Owned. Dev/calibration console, off the rig.
7in TFT LCD monitor (Jetson view) | 7in TFT LCD | HDMI + 12V | 1 |  | Y | $0 | Owned. Jetson perception monitor.
Checkerboard calibration target | owned | - | 1 |  | Y | $0 | Owned. Camera + bore-sight calibration. Rigid flat backing.
micro-HDMI to HDMI cable (Pi5 -> 10.1in) | microHDMI->HDMI | HDMI | 1 | $7 |  | $7 | Pi5 has micro-HDMI out.
DisplayPort -> HDMI adapter (Jetson -> 7in) | DP->HDMI | HDMI | 1 | $9 |  | $9 | AGX Orin dev kit is DisplayPort; verify.
INTERCONNECT / MOUNTING
GPIO stacking header, 2x20 tall | Adafruit 2223 | - | 1 | $3 |  | $3 | Passes GPIO up past the solenoid HAT (only one HAT now).
Top-of-stack GPIO breakout / proto-HAT | Adafruit 2310 | - | 1 | $8 |  | $8 | Expose SPI (IMU), UART (lidar + Pico), spare GPIO.
Brass standoff / spacer kit (M2.5) | M2.5 standoff kit (gen.) | - | 1 | $8 |  | $8 | Mount/space the HAT + Pi.
Ethernet cable, Cat6 (short) | Cat6 (gen.) | Ethernet | 1 | $6 |  | $6 | Direct Pi<->Jetson; service loop for motion.
POWER
24-48V DC supply (>=6A) for steppers | Mean Well LRS-350-48 | - | 1 | $45 |  | $45 | Stepper drivers. Higher V = higher speed.
12V DC supply (>=3A) - solenoid only now | Mean Well GST60A12 | - | 1 | $16 |  | $16 | Solenoid rail (motors moved to 24-48V). Buck from 48V if you want one supply.
Inline fuse holders + fuses | ATC holders + fuses (gen.) | - | 1 | $8 |  | $8 | Fuse the 24-48V and 12V rails. Tie ALL grounds together.
WIRING
Jumper wires (DuPont M-F, M-M) | gen. | - | 1 | $7 |  | $7 | Signals: IMU, lidar, Pico, switches.
Hookup wire, 18-20 AWG | gen. | - | 1 | $10 |  | $10 | Motor, solenoid, power runs.
Wire ferrules / crimp terminals | gen. | - | 1 | $9 |  | $9 | Driver/terminal terminations.
TOTAL TO BUY (excludes items marked Have=Y) |  |  |  |  |  | $971

Sheet: Connection Map
Device | Natural Protocol | Where it connects | Notes
Pan stepper (NEMA 23 CL) | step/dir/enable | CL driver <- Pico | Encoder feedback closed in the driver.
Tilt stepper (NEMA 23 CL) | step/dir/enable | CL driver <- Pico | Torque-critical axis (gravity).
Closed-loop drivers x2 | 24-48V + step/dir | 24-48V rail; Pico GPIO | Each reads its motor encoder.
Motion coprocessor (Pico) | UART/SPI | to Pi; step/dir to drivers | Real-time step gen, profiling, homing.
Limit / homing switches | GPIO | Pico inputs | Power-up homing -> absolute aim.
Solenoid (trigger) | 12V switched | Solenoid HAT MOSFET out | Arming switch in series on 12V.
Solenoid driver HAT | I2C | Pi I2C bus | Only HAT on the stack now.
Arming switch / relay | GPIO + 12V | in 12V solenoid line | Hardware firing interlock.
BNO085 IMU | SPI | Pi SPI0, own CS | No magnetometer.
TF03 lidar | UART | Pi native UART | Bore-sighted to the muzzle.
OLED screen | I2C | Pi I2C bus | On-gun status.
Jetson AGX Orin | Ethernet | Direct Cat6 to Pi | Targeting; ROS2/DDS.
ZED 2i camera | USB 3.0 | Jetson USB3 port | Vision system; not on the Pi.

Sheet: Integration Notes
Bus map, motion & wiring rules
- Bus map: I2C = solenoid HAT + OLED. SPI = IMU. UART = lidar + Pico link. Ethernet = Jetson. (The motor HAT is gone with the Vidpro.)
- MOTION cascade: Jetson (targeting) -> Pi (supervisor: IMU, lidar, arming, setpoints) -> Pico (real-time step/dir + motion profiles) -> closed-loop drivers -> NEMA 23 steppers. Don't generate step pulses on the Pi; Linux isn't real-time and the jitter shows as rough motion.
- Sizing: tilt is the hard axis (gravity). Keep payload CG within ~10cm of the tilt axis -> ~4.5 Nm to hold; design ~2x for recoil/accel (~10 Nm). NEMA 23 (~3 Nm) x ~5:1 = ~15 Nm at axis, with >100 deg/s to spare.
- Reduction: planetary (stiff, low backlash) is the default for aiming. A worm on tilt self-locks - holds elevation against gravity/recoil with zero holding current - at the cost of speed.
- Homing: a limit switch (or absolute encoder) per axis sets a known zero at power-up. With the encoders, that gives true ABSOLUTE aiming - command angles directly; visual servoing becomes a refinement, not the only position source.
- Structure: metal in the load path (frame, shafts, bearings) - recoil + 10 lb is too much for printed plastic there. Printed parts fine for brackets/covers. Drive the pan axis through a slewing/thrust bearing, never off the motor shaft.
- Power rails: 5V (Pi), 12V (solenoid only now), 24-48V (steppers; higher = faster). Tie ALL grounds together; the Ethernet link is isolated so Pi<->Jetson needs no shared ground. Fuse each rail.
- IMU: one BNO085 on SPI (gun rigid to platform, no flex). Mag off; pitch/roll absolute from gravity, yaw drifts and the camera supplies heading. Leveling: tilt nulls pitch, roll is leveled at the tripod legs; raw gravity vector when static, quaternion through steep angles.
- Bring-up: define the Pi<->Jetson command protocol now and have the console emit those exact frames, so human-as-Jetson and the real Jetson are interchangeable. Validate tracking on the 7in with the trigger disarmed before autonomy and the interlock meet.
- Coloring: green = owned (excluded from total). Orange = new/reworked motion parts. Generic SKUs are representative specs; prices are ballpark USD.
