sean-galloway/jetson-marker-turret/turret-gimbal/cad/dxf/01_interface_plate_PA4.dxf

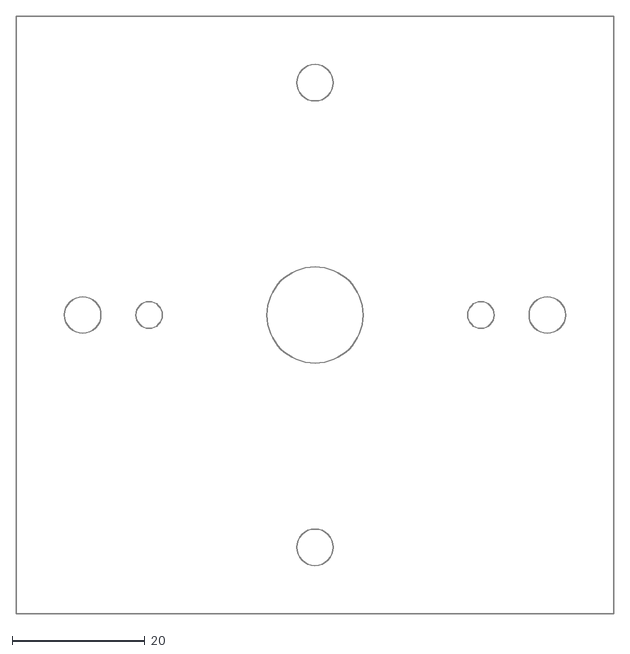
[picture p18: CAD file, 2026-06-21]
turret-gimbal/cad/dxf/01_interface_plate_PA4.dxf
90.0 x 90.0
