sean-galloway/jetson-marker-turret/turret-gimbal/cad/dxf/06_tripod_adapter.dxf

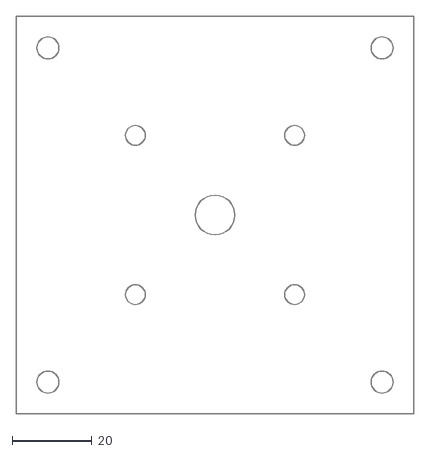
[picture p19: CAD file, 2026-06-21]
turret-gimbal/cad/dxf/06_tripod_adapter.dxf
100.0 x 100.0
