sean-galloway/jetson-marker-turret/turret-gimbal/cad/dxf/03_turntable_plate.dxf

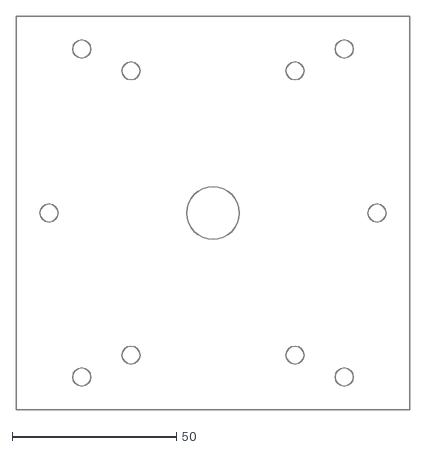
[picture p20: CAD file, 2026-06-21]
turret-gimbal/cad/dxf/03_turntable_plate.dxf
120.0 x 120.0
