sean-galloway/jetson-marker-turret/turret-gimbal/cad/dxf/05_yoke_side_trunnion.dxf

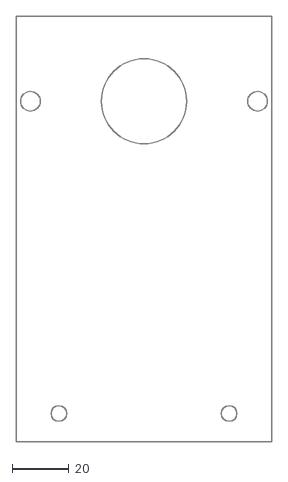
[picture p21: CAD file, 2026-06-21]
turret-gimbal/cad/dxf/05_yoke_side_trunnion.dxf
90.0 x 150.0
