sean-galloway/jetson-marker-turret/turret-gimbal/cad/dxf/04_yoke_side_gearbox.dxf

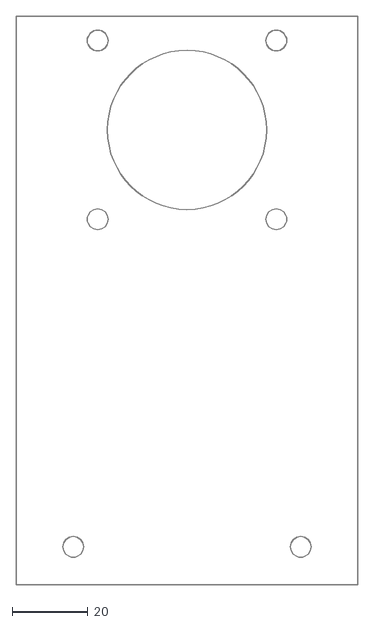
[picture p22: CAD file, 2026-06-21]
turret-gimbal/cad/dxf/04_yoke_side_gearbox.dxf
90.0 x 150.0
