sean-galloway/jetson-marker-turret/turret-gimbal/cad/dxf/02_base_plate_pan.dxf

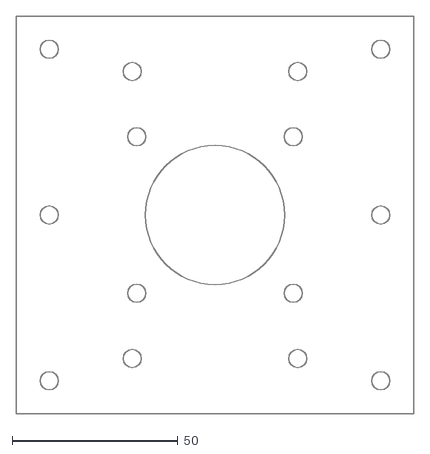
[picture p23: CAD file, 2026-06-21]
turret-gimbal/cad/dxf/02_base_plate_pan.dxf
120.0 x 120.0
