sean-galloway/jetson-marker-turret/turret-gimbal/cad/FreeCAD_Setup.md

# FreeCAD setup & asset download checklist

Everything needed to assemble the turret in FreeCAD. Use **FreeCAD 1.0+** (built-in
Assembly workbench; fixes the old topological-naming issues).

Drop downloaded models into `turret-gimbal/cad/step/`. Plate solids generated by
`tools/freecad_build.py` go in `cad/step/plates/`.

---

## 1. Software to install
| Tool | URL | Why |
|---|-----|-----|
| **FreeCAD 1.0+** | https://www.freecad.org/downloads.php | Modeling + built-in **Assembly** + **TechDraw** |
| **Fasteners** workbench | FreeCAD → Tools → **Addon Manager** → "Fasteners" | Generate ISO/DIN screws, nuts, standoffs, dowels on the fly (no STEP needed) |
| **OpenSCAD** | https://openscad.org/downloads.html | Render the parametric parts I wrote (`cad/scad/*.scad`) → export STL/STEP |

Accounts you'll likely need for some downloads:
- **GrabCAD** (free): https://grabcad.com/library — community models (Pi, Jetson, switch).
- **NVIDIA Developer** (free): https://developer.nvidia.com — Jetson design resources.

---

## 2. Already in this repo — no download
- **6 flat plates** → run `freecadcmd turret-gimbal/tools/freecad_build.py` to get 6 mm solids (also exports STEP to `cad/step/plates/`).
- **Lazy-susan pan bearing** → model from `docs/Bearing_Dimensions.md` (OD 201.54, bore 144.36, BCDs 188.66/157.04).
- **Rack shelf** + **turret electronics base** → render `cad/scad/rack_shelf.scad` and `cad/scad/turret_electronics_base.scad` in OpenSCAD.

---

## 3. Download — gimbal core (do these first; the active design)
| Part | BOM # | Where | Notes |
|---|---:|---|---|
| NEMA 23 motor 23HS45-4204D-E1000 | 33 | https://www.omc-stepperonline.com (search P/N) | Product page → **Download** tab → STEP |
| Planetary gearbox 5:1 (NEMA 23, Ø8) | 34 | omc-stepperonline.com | 3D model / STEP on the listing |
| CL57T V4.1 driver | 33 | omc-stepperonline.com | For the electronics-base fit |
| Tilt bearing — McMaster **5968K71** | 36 | https://www.mcmaster.com (search P/N) | Product page → **Download → 3-D → STEP** (no login) |
| Mounting hub — Ruland **FHT-MCL-14-SS** | 37 | https://www.ruland.com (search P/N) | Product page → CAD download |
| Shoulder screw — McMaster **90298A716** | 38 | mcmaster.com | Download → 3-D STEP |
| Dowel pins — McMaster **91595A161** | 42 | mcmaster.com | Or just use the Fasteners WB |

## 4. Download — payload sensors
| Part | BOM # | Where | Notes |
|---|---:|---|---|
| ZED 2i | 5 | https://www.stereolabs.com/docs (Camera → mechanical/CAD) | STEP from Stereolabs |
| TF03 lidar | 8 | https://www.benewake.com (TF03 product page) | Mechanical drawing / CAD |
| BNO055 IMU (DFRobot Gravity SEN0253) | 7 | https://wiki.dfrobot.com (SEN0253) | If no CAD, model from board dims |

## 5. Download — compute / electronics
| Part | BOM # | Where | Notes |
|---|---:|---|---|
| Jetson AGX Orin dev kit | 10 | NVIDIA Jetson Download Center / GrabCAD | Login; or model the 109×109×75 box |
| Raspberry Pi 5 | 11 | https://datasheets.raspberrypi.com + GrabCAD | Mechanical PDF + community STEP |
| Raspberry Pi Pico | 20 | datasheets.raspberrypi.com + GrabCAD | Small; community STEP |

---

## 6. Model from dimensions (no good STEP — build it yourself)
- **Lazy-susan bearing** (use measured dims, §2).
- **Rack + GeeekPi parts** (DeskPi RackMate T2, 10" PDU, 12-port patch panel, switch mount, 6.91" displays) — grab dimensions from the product pages / deskpi.com & 52pi.com and model simple blocks; the rack mostly sets the shelf interface.
- **TP-Link TL-SG108E** — GrabCAD or a dimensioned block.
- **RadioMaster TX16S / ELRS RX** — not needed for the turret CAD.
- **Screws / nuts / standoffs / dowels** — generate with the **Fasteners workbench** instead of downloading.

---

## 7. Suggested order of work in FreeCAD
1. Run `freecad_build.py` → 6 plate solids.
2. Import the gimbal-core STEPs (motor, gearbox, bearings, hub, shoulder screw).
3. Model the lazy-susan from dims.
4. Assemble pan + tilt (Assembly WB); add fasteners (Fasteners WB).
5. Add the payload sensors once the **marker scan** lands (drives the shroud + frame).
6. TechDraw pages for per-step build drawings; exploded view for the blow-up.
