sean-galloway/jetson-marker-turret/(commit log)

2026-06-21 chore: add BOM markdown tooling, bearing dims, src + analysis scaffold
    Tooling & docs:
    - turret-gimbal/tools/bom2md.py: generate Markdown views of the BOM from the
    canonical bom/Turret_BOM.xlsx (path-independent). Emits a table view with a
    Bought checkbox and a clickable checklist with Ordered/Received boxes.
    - Turret_BOM.md, Turret_BOM_checklist.md: generated outputs; item #33 links to
    the measured bearing dimensions.
    - turret-gimbal/docs/Bearing_Dimensions.md: measured lazy-susan pan bearing
    (OD 201.54, bore 144.36, BCDs 188.66 / 157.04, 4x M4 per ring, flat-head).
    Scaffold:
    - src/{jetson,pi5,pico}: per-processor dirs with READMEs and runtime
    requirements (Pico is MicroPython ->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
2026-06-21 chore: commit full turret-gimbal project tree and root BOM workbook
    Bring the previously-untracked gimbal project under version control: CLAUDE.md,
    README, BOM workbooks (bom/), DXF plate set (cad/dxf/), datasheets, and the
    build/assembly docs (md + pdf) with their image assets. Also tracks the
    repo-root Turret_BOM.xlsx. Ignore redundant *.zip source archives.
    Claude-Session: https://claude.ai/code/session_019gaQEbG869TpTLwsBrmpBf
    [01_interface_plate_PA4.dxf, 02_base_plate_pan.dxf, 03_turntable_plate.dxf, 04_yoke_side_gearbox.dxf, 05_yoke_side_trunnion.dxf, 06_tripod_adapter.dxf, Gimbal_BOM.xlsx, RPi_Turret_Parts_List.xlsx]
2026-06-21 feat: swap IMU to DFRobot Gravity BNO055 (SEN0253); harden bom2md totals
    - BOM #7: BNO085 (Adafruit 4754, SPI) -> DFRobot Gravity 10-DOF BNO055+BMP280
    (SEN0253, $25.90). Solderless Gravity I2C plug. Grand total -> $1,216.86.
    - bom2md.py: compute line totals and section summaries from qty x unit instead
    of trusting Excel's cached formula values (openpyxl drops them on save).
    - Notes capture the two firmware caveats: run IMU mode (no mag) near steppers,
    and lower Pi I2C baud for the BNO055 clock-stretch quirk.
    - Sync refs: src/pi5 requirements (bno08x -> bno055) + README, CLAUDE.md and
    Payload_Top_Module.md IMU mentions. Regenerated BOM markdown.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
    [Turret_BOM.xlsx]
2026-06-21 chore: retire BOM xlsx + generator; Markdown is now the source of truth
    The user maintains the BOM directly in the Markdown files now.
    - Delete Turret_BOM.xlsx (root + turret-gimbal/bom/) and turret-gimbal/tools/bom2md.py.
    - requirements.txt: drop openpyxl (only the generator used it).
    - CLAUDE.md: point to Turret_BOM.md / Turret_BOM_checklist.md as the live BOM;
    remove the "keep the xlsx in sync / edit cells" guidance and openpyxl tooling note.
    Turret_BOM.md / Turret_BOM_checklist.md are hand-edited from here on; do not
    regenerate them from a spreadsheet.
    Claude-Session: https://claude.ai/code/session_019gaQEbG869TpTLw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
    [Turret_BOM.xlsx]
2026-06-21 chore: move legacy BOM spreadsheets into bom/legacy/ with a README
    Avoid confusion with the live Markdown BOM: relocate the three superseded
    spreadsheets (Gimbal_BOM, RPi_Turret_Parts_List, Turret_Full_Parts_List) into
    turret-gimbal/bom/legacy/ and add a README marking them history-only.
    Update CLAUDE.md repo layout accordingly.
    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
    [Gimbal_BOM.xlsx, RPi_Turret_Parts_List.xlsx, Turret_Full_Parts_List.xlsx]
2026-06-21 feat: add FreeCAD script to extrude plate DXFs into 6mm solids
    turret-gimbal/tools/freecad_build.py imports each cad/dxf/*.dxf, builds a face
    (largest closed wire = outline, circles = holes) and extrudes to 6 mm. Saves
    one FCStd per plate (cad/freecad/) and a neutral STEP (cad/step/plates/) for
    assembly in any CAD tool. Run with `freecadcmd turret-gimbal/tools/freecad_build.py`.
    Also ignore FreeCAD backup/lock files.
    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
2026-06-21 docs: add STEP sourcing checklist for catalog/electronics parts
    cad/step/SOURCES.md maps each physical BOM part to where its STEP lives
    (vendor CAD downloads, community models, or model-from-dims). Notes that
    McMaster/NVIDIA/StepperOnline CAD is login/anti-bot gated and must be fetched
    by hand. Add cad/step/plates/ as the script's STEP output dir.
    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
2026-06-21 chore: create cad/step/plates output dir
2026-06-21 chore(bom): move Pico to Compute & Control (#20); renumber, sync totals
    The Pico is a controller, so it now lives in Section B next to the Pi 5/Jetson
    instead of the gimbal catalog (E). Pico -> #20; old #20-#38 shift to #21-#39;
    F/G unchanged. Pico's $5 moves from catalog (E) into electronics (A-D):
    totals now Grand $1,216.86 / A-D $551.90 / E $505.96. Shoulder-screw cross-ref
    follows the tilt bearing (#34 -> #35). Preserved all 26 user-ticked checkboxes
    and the checklist's loose-list formatting; synced the checklist's stale totals
    to match the table.
    Claude-Session: https://claude.ai/code/session_019gaQEbG869TpTLwsBrmpBf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
2026-06-21 bom: set solenoid #2 to TOMMSILE 0837B-12V ($13.99), switch #3 to Taiss SPST KNS-1 ($7.99); update totals
2026-06-21 feat(bom): add hardware-tied armed/safe LED (#9); repurpose OLED to Pico debug (#21)
    - #9 OLED -> Armed/Safe LED indicator (red+green, RED ARMED hardware-tied to the
    armed rail; on the turret). New $3 item.
    - OLED (Adafruit 938) repurposed as the Pico debug display -> #21 in Compute &
    Control (shows current routine/state, step/dir, homing, heartbeat, faults).
    Carried its existing "Ordered" tick.
    - Renumber old #21-#50 -> #22-#51; cross-ref #35 -> #36; totals now
    Grand $1,213.84 / A-D $548.88.
    - Fixed a pre-existing divergence: checklist #7 still showed the old BNO085;
    synced it to the BNO055 (SEN0253) to match the table (kept its tick).
    - Synced src/pi5 (Pi 5 no longer drives the O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
2026-06-22 feat: add ground-station rack architecture (BOM Section H + CLAUDE.md)
    Compute moves off the tripod into a 10" control rack; the tripod carries only
    the gimbal+payload on a mechanical quick-release, linked by one sleeved umbilical.
    - BOM Section H (#52-62, appended after G — no renumber): 10" rack, 10" PDU
    (all AC onboard), E-stop (drops both rails), gigabit switch, DIN rail/terminal
    + ground bus, umbilical connectors + bulkhead, cable sleeve, vent/blank panels,
    cable mgmt, plus MAKE items (Jetson/Pi5/Pico shelf, 3U display panels).
    Totals: + rack (H) $265 -> Grand $1,478.84. Prices are estimates.
    - CLAUDE.md architecture rewritten: tripod = turret only + umbilical; control
    rack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
2026-06-22 feat(bom): record purchased rack parts (DeskPi RackMate 10" ecosystem)
    Update Section H to actual parts and add 3 new ones (all bought, Ordered ticked):
    - #53 PDU -> ElecVoztile 10" 8-outlet (surge, 15A), 1U
    - #55 switch -> TP-Link TL-SG108E (8-port gigabit, managed)
    - +#63 GeeekPi 6.91" 1424x280 1U rack touchscreen (status/console bar)
    - +#64 GeeekPi 12-port Cat6 patch panel, 1U (network breakout)
    - +#65 1U PETG rack mount for the TL-SG108
    - #62 display panels marked TBD pending the display plan.
    Totals: rack (H) $362, Grand $1,575.84. Rack-part prices are estimates pending
    actual paid amounts.
    Claude-Session: https://cla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
2026-06-22 bom: record DeskPi RackMate T2 (12U, 10.23" deep) as the rack (#52, bought)
2026-06-22 feat(bom): consolidate displays to 2x GeeekPi 6.91" 1U; drop 10.1"/7"
    - #22/#23 repurposed (in place) to the two 6.91" 1U rack displays (Pi 5 + Jetson);
    the 10.1" touch and 7" TFT are for another project and are removed here.
    - Removed #62 (3U display panels — not needed) and the duplicate H 6.91";
    old #64/#65 (patch panel, switch mount) -> #62/#63. Now 63 items, contiguous.
    - #25/#26 cables re-noted to feed the 6.91" displays.
    - Totals: displays now priced -> A-D $668.88, H $302, Grand $1,635.84 (display
    price $60/ea est.). All user ticks preserved (asserted).
    Claude-Session: https://claude.ai/code/session_019gaQE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
2026-06-22 feat(cad): parametric OpenSCAD rack shelf (Jetson pocket + Pi5/Pico standoffs)
    [rack_shelf.scad]
2026-06-22 bom: actual rack-part prices + cable managers qty 2
    From order screenshots: displays #22/#23 $89.99 ea, PDU #53 $69.99, switch #55
    $19.99, patch panel #62 $24.99, switch mount #63 $34.99; cable management #60
    -> qty 2 (Ordered). Totals recomputed from line items: A-D $728.86, H $379.96,
    Grand $1,773.78. (Rack #52 + unbought H items remain estimates.)
    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
2026-06-22 bom: cable manager #60 = Tecmojo 2-pack 0.5U $9.90 (was 2x$10); totals -> $1,763.68
2026-06-22 cad(shelf): add Jetson height (75mm w/ feet); note fan-direction + 3U headroom
    [rack_shelf.scad]
2026-06-22 cad(shelf): confirm Jetson bottom-intake; enlarge floor vent to 90mm, keep bay below open
    [rack_shelf.scad]
2026-06-22 feat: add TX16S operator console (BOM Section I); move IMU to the Pico
    - BOM Section I (#64-66): RadioMaster TX16S Mk II (ELRS), ELRS CRSF receiver,
    2x 18650 cells — manual jog + telemetry console (MOTION ONLY). Totals: +I $266.99
    -> Grand $2,030.67 (radio/RX/cells price est.).
    - IMU re-homed to the Pico for real-time leveling (avoids the Pi BNO055
    clock-stretch issue). IMU I2C now crosses the umbilical -> note P82B715 extender
    or BNO055 UART. Pi 5 gets orientation from the Pico instead of reading it.
    - Pico gains: IMU read, level routine (tilt->horizon + reset ref; roll reported,
    not actuated), and CRSF RC jog (failsafe -> stop-hold). Updated CLAUDE.md
    architecture/signal-chai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
2026-06-22 refactor(arch): move Pico + CL57T drivers onto the turret
    Real-time motion node (Pico + 2x CL57T) now lives on the turret with the motors,
    so the IMU/limits/LED are local short runs — the IMU I2C no longer crosses the
    umbilical (P82B715 extender dropped). Umbilical now carries only 48V/12V power,
    Pi5<->Pico comms (UART/USB), ZED USB, and ground.
    Updated CLAUDE.md architecture + signal chain; BOM notes #7 (IMU local), #20
    (Pico on turret w/ drivers), #57 (umbilical contents); src/pico README. Trade-off
    noted: drivers add weight/heat to the platform -> vented enclosure on the gimbal.
    Claude-Session: https://claude.ai/code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
2026-06-22 feat: turret electronics base (model) + barrel shroud (BOM); Section J printed parts
    - BOM Section J (#67/#68, MAKE): turret electronics base (Pico + 2x CL57T + IMU,
    vented, bolts to pan base plate) and barrel shroud (boresight mount for ZED +
    lidar). Shroud gated on the marker scan.
    - cad/scad/turret_electronics_base.scad: parametric model — drivers drop into
    open-end pockets, Pico/IMU on standoffs, floor vents, corner mount holes.
    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
    [turret_electronics_base.scad]
2026-06-23 docs(cad): FreeCAD setup + asset download checklist (supersedes step/SOURCES.md)
2026-06-23 docs: add manual/RC operations CONOPS (level/center/range/sweep/pause)
    docs/Operations.md captures the arm-off manual flow: home -> level (tilt to
    horizon) -> aim barrel at FOV center -> Center button sets zero/sweep center;
    90 deg / 180 deg pan arc centered on that heading; sweep on/off + speed knob;
    sweep-pause dwells 5 s at each 45 deg across the arc. RX failsafe -> stop-hold,
    arm switch off throughout. Suggested TX16S control map included. Folded the
    behaviors into src/pico README and referenced from CLAUDE.md.
    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
2026-06-23 docs: add Drive_and_Cabling.md (through-bore service loop, no slip ring)
    Locks the drive + cable scheme before FreeCAD frame work: pan via lazy-susan +
    coaxial 5:1 gearbox through the bore; tilt via 5:1 + hub + trunnion bearing.
    Cables cross the pan axis through the ~144mm bore as a service loop (no slip ring
    - enabled by the 90/180 sweep limit; also the ZED USB3 can't pass a slip ring).
    Documents what crosses each axis (IMU stays on the static base). Updated the
    stale "service loop or slip ring" line in CLAUDE.md to the decision.
    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
2026-06-23 bom: confirm RP3 CRSF receiver (#65) $24.99; totals -> $2,040.66
2026-06-25 chore(bom): update purchase checklist — mark items ordered/received
    Tick Ordered/Received boxes as parts have arrived (checklist tracking only;
    no spec changes).
    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
2026-06-25 docs(bom): note solenoid wiring — high-current channel (CH1-4) + onboard TVS
    Confirmed from Sequent's specs: the Eight-MOSFETs HAT high-current channels
    (CH1-4, 12A@24V) have onboard TVS clamping, so the 12V/1A trigger solenoid needs
    no external flyback diode. Recorded on #2 (solenoid) and #15 (HAT). CH5-8 are the
    240V/flyback-diode channels.
2026-06-25 bom: #27 12V solenoid supply -> Wefomey adjustable ($17.99, ordered)
    Swap the Mean Well placeholder for the bought Wefomey 3-24V/3A/72W adjustable
    adapter (set & lock at 12V; center-positive). Totals: A-D $730.85, Grand $2,042.65.
2026-06-25 docs(bom): clarify solenoid is rack-switched over the umbilical; fix stale #29 note
    - Drive_and_Cabling.md: note the 8-MOSFET HAT (Pi 5, rack) switches the solenoid
    (Pico never in the firing path), so the umbilical carries the switched solenoid
    PAIR (2 conductors: armed +12V feed + switched return) — account for both in the
    connector pinout.
    - #57 umbilical note updated to list the switched solenoid pair.
    - #29 Ethernet note fixed: Pi↔Jetson is now a short rack-internal patch via the
    switch (#55), not on the umbilical / no service loop (both are in the rack).
2026-07-01 cad(shelf): real RackMate T2 mount pattern from measured 1U panel
    Confirmed rack interface: 254mm face, U=44.23, four horizontal OVAL slots
    (9.33 x 6.77) with edge gaps 4.3mm (sides) / 3mm (top/bottom) -> slot centers
    8.965mm from sides (236.07mm C-C) and 6.385mm from top/bottom edges. Rewrote the
    flange with the true 4-corner oval-slot pattern; drop the guessed circular-slot
    params. Renders to a clean manifold STL in OpenSCAD.
    [rack_shelf.scad]
2026-07-02 cad(shelf): rack mount pattern from mfr drawing (238x33 hole C-C)
    Refine to the 10" 1U patch-panel mechanical drawing: 254x44 panel, hole C-C
    238mm horizontal / 33mm vertical -> oval slots 8mm from side edges, 5.5mm from
    top/bottom. Supersedes the hand-measured 236.07/31.46. Renders clean (manifold);
    echo confirms slot centers 8 / 5.5, C-C 238, 3U flange = 132mm.
    [rack_shelf.scad]
2026-07-02 bom: E-stop -> Gebildet 2NC2NO ($9.99, ordered); add DC contactor #64 for 48V
    - #54: E-stop = Gebildet 22mm 2NC2NO latching, 3A, $9.99, ordered. Breaks 12V
    solenoid directly + pilots the 48V contactor; spare NO -> Pi "E-stop pressed".
    - #64 (new, Section H): DC contactor for the 48V rail (E-stop can't switch 10A DC
    at 3A). Renumbered old #64-68 -> #65-69. Totals: H $384.85, Grand $2,057.64.
2026-07-02 bom: set #64 to 48V continuous-duty cutoff solenoid (Club Car B00UZ7XTP6, $20)
    Replace the generic DC-contactor placeholder with a concrete 48 V
    continuous-duty SPST-NO solenoid. E-stop NC breaks the small coil
    current (fed from the line side of the 48 V rail) to open the motor
    rail fail-safe. Contacts are DC-rated for 48 V (golf-cart main circuit),
    unlike an AC lighting contactor. Retitle #54's cross-ref accordingly.
    Totals: grand $2,057.64 -> $2,052.64; rack (H) $384.85 -> $379.85.
2026-07-02 bom: repoint #64 to cheaper 48V continuous-duty solenoid (10L0L B0C9SZV1KX)
    The premium Club Car unit (B00UZ7XTP6) is $129 — overkill for a ~10 A
    rail. Swap to the standard 10L0L 48 V 4-terminal 200 A continuous / 600 A
    peak solenoid (~$20): same continuous-duty, 48 VDC-rated contacts, much
    cheaper. Same E-stop wiring (coil off the line side of the 48 V rail).
    Price/totals unchanged.
2026-07-02 bom: repoint #64 to in-stock universal 48V solenoid (B0076Q9HNM) + backups
    10L0L (B0C9SZV1KX) is unavailable. Point to the generic universal 48 V
    200 A continuous solenoid and list two backup ASINs (EZGO 73231G01
    B0076Q9FFM, GCK Yamaha B00S0QR68K). Same class/wiring, price unchanged.
2026-07-02 bom: set #64 to 10L0L #586 48V solenoid ($34.99), update totals
    Confirmed part: 10L0L #586-series 48 V 4-terminal solenoid (200 A work /
    500 A inrush, copper), EZGO 73231G01 replacement. Price $34.99.
    Totals: grand $2,052.64 -> $2,067.63; rack (H) $379.85 -> $394.84.
2026-07-02 bom: lock in #28/#56/#57/#59 with concrete parts + links
    - #28 Circuit protection: split fusing — ATC (SIM&NAT B0CN6TVHKH) for
    12 V/logic (blade fuses are only 32 VDC-rated) + DIHOOL 15 A DC breaker
    (B0CFCLPGNY) for the 48 V rail (DC-rated, doubles as manual disconnect).
    $8 -> $26.
    - #56 DIN rail: ICI Dinkle DK2.5N kit (B07NVV28D9). $20 -> $23.
    - #57 Umbilical: GX20 12-pin (B0D4VBV42Q, 5 A/pin -> 48 V pair on 3 pins
    each) + PENGLIN USB3 IP67 coupler (B09VNS64HM) for the ZED (aviation
    connectors degrade USB3). $40 -> $30.
    - #59 Blank/vent panels: 3D-print, $15 -> $0.
    Totals: grand $2,067.63 -> $2,063.63; A-D $730.85 -> $748.85;
    rack (H) $394.84 -> $372.84.
2026-07-07 feat: IMSAI-8080 front panel as the 3U compute bay face
    Roll the RaspberyPi-IMSAI-8080 smart panel into the ground station as the
    front face of a merged 3U bay holding the Jetson AGX Orin + Pi 5, and remap
    it as a soft turret HMI (status + soft control only; never in the hardware
    arming/E-stop/firing path).
    CAD (turret-gimbal/cad/scad/rack_shelf.scad):
    - Front fascia = the IMSAI bezel: 4 LED windows, 12 toggle holes (8 DPDT data
    + 4 MTS-123 momentary command), back-counterbored so the bushing nut catches.
    - 6 PCB standoff bosses; content re-centred (equal side margins); tray widened
    to 214 mm [MEASURE].
    - Debossed legend (paint-fill), generated on the same grid as the artwork.
    - Tray su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
2026-07-08 bom: switch part selections + purchase status
    - #3 arming switch → Twidec ASW-07DRGYMZ (SPST, 20 A, LED, flip cover);
    LED-ground wiring note; "real interlock, not the panel's soft ARM".
    - #9 armed/safe LED → FILN 12 mm IP67 (red + green); green via 12 V SPDT
    relay for true XOR, or as a power/ready light.
    - #19 limit/homing → R REIFENG 3D-printer mechanical endstop (6-pack).
    - Mark bought/received: #2,3,4,7,8,9,11,12,14,15,16,19,20,21,29,33,34,35,36,41,65,66,67
    (BOM Bought column + checklist Ordered/Received).
    - Totals refreshed for the #3/#9/#19 price changes.
2026-07-08 bom: mark #13/#17/#18/#25/#26 bought
2026-07-08 bom: add #70 IMSAI panel switch harness (JST-XH J3/J4) + totals
2026-07-14 chore: remove IMSAI/IMSPI panel work from the turret repo
    The IMSAI/IMSPI 3U rack panel is moving to its own repo
    (RaspberyPi-IMSAI-8080) and will be pulled back in as a submodule once
    stable. Strip it from here:
    - restore cad/scad/rack_shelf.scad to its pre-IMSAI Jetson/Pi/Pico shelf
    - delete imsai_paddle_cap.scad, cad/panel/gen_front_panel.py,
    docs/Imsai_Panel_HMI.md, docs/assets/imsai_panel_front.svg
    - revert BOM #61 to "Jetson/Pi 5/Pico rack shelf", drop #70 (panel switch
    harness), restore totals; keep the switch/purchase edits (#3/#9/#19 etc.)
2026-11-02 docs: RS-485 Pi 5<->Pico link, Zero maintenance node, CL57T V4.1 driver setup
    - Pi 5 -> Pico command link is RS-485 (half-duplex, one twisted pair over the
    umbilical, 230400 baud, COBS + CRC-16, 20 ms heartbeat originating on the
    Pi 5); GX20-12 umbilical pin map; turret 5 V logic rail with the open
    decision on its 48 V feed point.
    - Pi Zero 2 W as an optional maintenance node (Pico flashing/logs over USB),
    never in the command or heartbeat path.
    - CL57T V4.1 manual filed in datasheets; switch settings (S1=4, 1600 ppr,
    SW6/7/8 OFF, S3=5 V), step/dir timing, 74LVC07A open-drain buffer wiring,
    ALM/BRK outputs and fault codes in Drive_and_Cabling.md.
    - BOM: new #70 RS-485 transceiver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
2026-11-02 docs: Pi 5 motor-rail enable via MOSFET HAT CH5 in the #64 coil return
    The 48 V cutoff solenoid's coil return now runs E-stop NC -> HAT CH5 -> GND,
    so the Pi 5 can cycle the motor rail (the only way to clear a latched CL57T
    fault) while the E-stop still breaks the coil independently. Motors stay
    unpowered until the Pi 5 enables CH5. Notes the coil-current check against
    CH5's rating and the interaction with the turret 5 V feed-point decision.
2026-11-03 docs: 10-inch rack panel and mounting-hole specs
    Panel envelope and hole pattern for rack-mount faces in the DeskPi RackMate T2
    (BOM #52): compute shelf (#61), blank/vent panels (#59) and the panel fascia.
